Chipizdry/Inverters-in-development/100kW_380V_Inverter/DC-DC-Conv/Снимок экрана 2026-07-19 193247.png

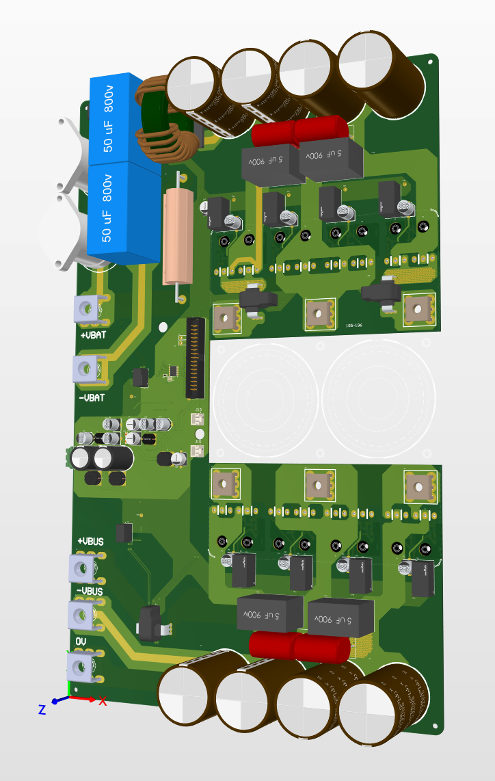
100kW_380V_Inverter/DC-DC-Conv/Снимок экрана 2026-07-19 193247.png
