Chipizdry/Inverters-in-development/100kW_380V_Inverter/Driver/ADC_Comm/ADC_Comm/Снимок экрана 2026-07-13 130827.png

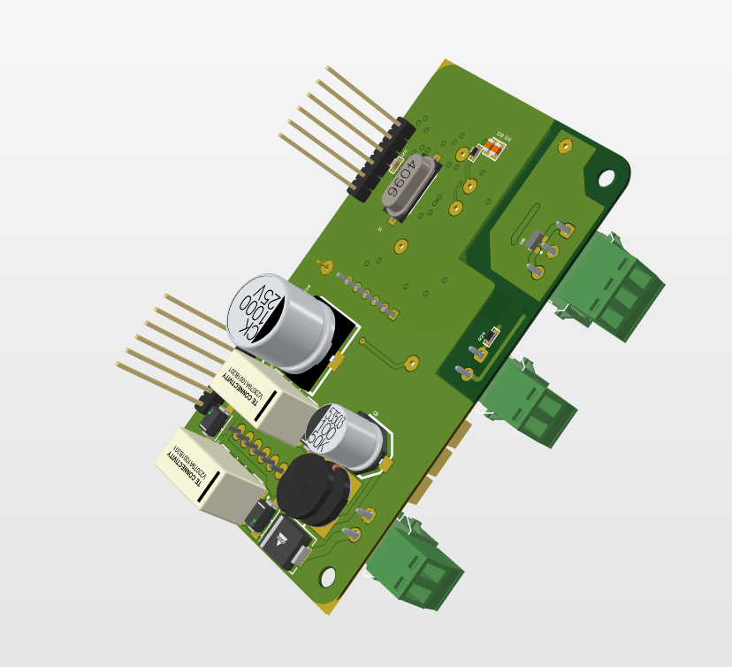
100kW_380V_Inverter/Driver/ADC_Comm/ADC_Comm/Снимок экрана 2026-07-13 130827.png
