Chipizdry/Inverters-in-development/100kW_380V_Inverter/Driver/PS_Filter/Project Outputs for PS_Filter/Снимок экрана 2026-05-31 180028.png

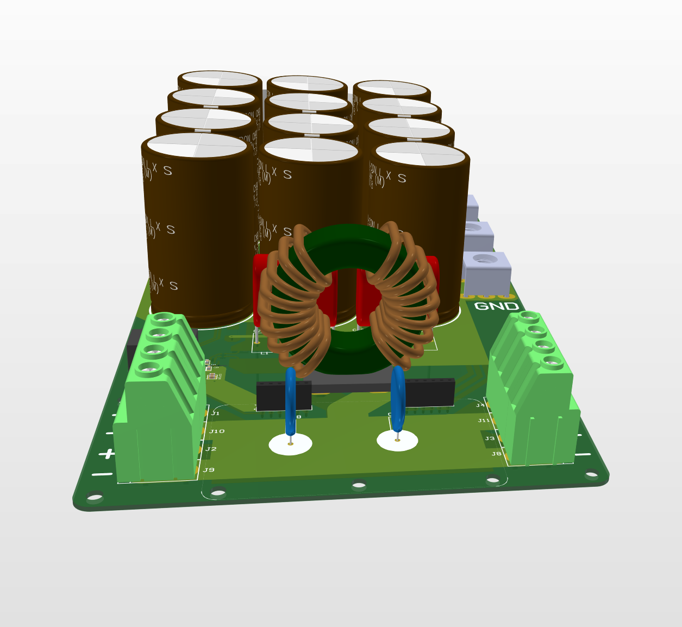
100kW_380V_Inverter/Driver/PS_Filter/Project Outputs for PS_Filter/Снимок экрана 2026-05-31 180028.png
