Chipizdry/Inverters-in-development/100kW_380V_Inverter/PS__INN3947CQ_V2/Project Outputs for Free Documents/BOM/BOM.xlsx

Designator | Quantity | Description | Footprint
C14 | 1 | 4.7uF | CAP-0805
C15 | 1 | 330pF 630V | CAP-1206
C16 | 1 | 1500pF 630V | CAP-1206
C17 | 1 | 2,2uF | CAP-1206
C18 | 1 | 470nF 100V | CAP-0805
C20 | 1 | 330pF | CAP-0805
C22 | 1 | 10nF | CAP-0805
C24 | 1 | 330pF 16V | CAP-0805
D2 | 1 | BAS21GWX | SOD-123
D4 | 1 | 1N4148 | SOD-123
D5 | 1 | PDZ15BGWJ | SOD-123
D6 | 1 | SS14 | DO-214AC, SMA
D7 | 1 | WURTH ELEKTRONIK - 151031YS06000 - LED, Yellow, Through Hole, T-1 (3mm), 30 mA, 2 V, 590 nm | LED_3mm_RED
IC1 | 1 | INN3947CQ | INN3947CQ
L1 | 1 | L_13x13mm | L_13x13mm
P1 | 1 | WR-TBL Series 7015B Open Horizontal PCB Header, SMT, pitch 5.08mm, 2p | 691701530002B
P2 | 1 | WR-TBL Series 7015B Open Horizontal PCB Header, SMT, pitch 5.08mm, 3p | 691701530003B
R12 | 1 | 8.2K | RES-0805
R16 | 1 | 100 OHM | RES-0805
R17 | 1 | 4,7 OHM | RES-0805
R20 | 1 | 9.1K | RES-0805
R22 | 1 | 100K | RES-0805
T1 | 1 | TRANS_PQ3220 | TRANS_PQ3220
C10, C11 | 2 | 6.8nF 630V | CAP-1206
C12, C13 | 2 | 10uF 50v | CAP-0805
D1, D3 | 2 | NRVUS2MA | SOD128, DO-214AC, SMA
Q1, Q2 | 2 | DMT15H017LPS | DMT15H017LPS_SWP
R1, R21 | 2 | 10K | RES-0805
R3, R6 | 2 | 7.5 OHM | RES-2512
R18, R19 | 2 | 12 OHM | RES-0805
R24, R25 | 2 | 0.027 OHM | RES-1206
C19, C21, C23 | 3 | 470uF 25V | CAPPOL_SMD_SIZE_E
C1, C2, C3, C4, C5, C6, C7, C8, C9 | 9 | 68nF 500V | CAP-1206
R4, R5, R7, R8, R9, R10, R11, R13, R14, R15 | 10 | 390K | RES-1206
