Chipizdry/Inverters-in-development/100kW_380V_Inverter/Driver/Driver_BLDC/Driver_PCB/Project Outputs for Driver_BLDC/Driver_BOM.xlsx

Comment | Description | Designator | Footprint | LibRef | Quantity | Model number | Manufacturer | Volume | 5 sets | Minimum quantity | Unit price | Total price
330pF | 330pF | C1, C2, C3, C87, C89, C90 | CAP-0805 | CAP-NON-POLAR | 6 | 0805B331K500NT | FH | 0805 | 30 | 100 | 0.004 | 0.443
100nF | 100nF | C4, C6, C64, C73, C97, C126 | CAP-0805 | CAP-NON-POLAR | 6 | 0805B104K500NT | FH | 0805 | 30 | 100 | 0.004 | 0.429
16V 100uF | 16V 100uF | C5 | CAP-TAN-D | CAP-POLAR | 1 | JVJ16V100M6x5 | JIERR | SMD,D6.3xL5.4mm | 5 | 10 | 0.043 | 0.429
47uF 16V | 47uF 16V | C7, C19, C21, C23, C30 | CAP-TAN-D | CAP-POLAR | 5 | JVJ16V47M5x5 | JIERR | SMD,D5xL5.4mm | 25 | 30 | 0.036 | 1.071
GRM21BR61C106KE15L | Chip Multilayer Ceramic Capacitors for General Purpose, 0805, 10uF, X5R, 15%, 10%, 16V | C8, C10 | FP-GRM21B-0_1-IPC_C | CMP-2007-03453-2 | 2 | GRM21BR61C106KE15L | muRata | 0805 | 10 | 20 | 0.021 | 0.429
0.1uF | 0.1uF | C9, C12, C13, C14, C15, C16, C17, C25, C29, C31, C35, C36, C38, C40, C42, C45, C46, C52, C53, C54, C59, C60, C62, C66, C69, C72, C75, C77, C82, C94, C112, C123, C143 | CAP-0805 | CAP-NON-POLAR | 33 | 0805B104K500NT | FH | 0805 | 165 | 200 | 0.004 | 0.857
2.2nF 2kV | 2.2nF 2kV | C11, C78, C81, C83, C84, C85 | CAP-V | CAP-V | 6 | R08E3E222MA5B0S0N0 | STE | CAP-V=7.5mm | 30 | 40 | 0.036 | 1.429
2.2uF | 2.2uF | C18, C48 | CAP-0805 | CAP-NON-POLAR | 2 | CL21A225KBQNNNE | SAMSUNG | 0805 | 10 | 50 | 0.017 | 0.857
1uF | 1uF | C20, C22, C24, C34, C56, C57, C70, C86, C102, C115, C138 | CAP-0805 | CAP-NON-POLAR | 11 | CL21B105KAFNNNE | SAMSUNG | 0805 | 55 | 100 | 0.011 | 1.143
47pF | 47pF | C26, C27 | CAP-0805 | CAP-NON-POLAR | 2 | 0805CG470J500NT | FH | 0805 | 10 | 100 | 0.006 | 0.571
1000pF | 1000pF | C28 | CAP-0805 | CAP-NON-POLAR | 1 | 0805B102K500NT | FH | 0805 | 5 | 50 | 0.004 | 0.214
100uF 16V | 100uF 16V | C32, C39, C61, C92, C110, C122, C142 | CAP-TAN-D | CAP_POL_SMD, CAP-POLAR | 7 | JVJ16V100M6x5 | JIERR | SMD,D6.3xL5.4mm | 35 | 50 | 0.039 | 1.929
1000uF 10V | 1000uF 10V | C33, C49, C63 | CAP_SMD_Size_G | CAP-POLAR | 3 | RVE10V1000M8X10 | JIERR | SMD,D8xL10.5mm | 15 | 30 | 0.071 | 2.143
1000uF_6.3V |  | C37, C43, C44, C50, C51, C67, C68 | CAP_SMD_Size_E | CAP-POLAR | 7 | JVJ6.3V1000M8X10 | JIERR | SMD,D8xL10.5mm | 35 | 50 | 0.071 | 3.571
220pF | 220pF | C41 | CAP-0805 | CAP-NON-POLAR | 1 | 0805B221K500NT | FH | 0805 | 5 | 50 | 0.006 | 0.286
25V_1000uF | 25V_1000uF | C47, C55 | HITANO 3300uF 25V 16x25 | CAP-POLAR | 2 | JVJ25V1000M10X12 | JIERR | SMD,D10xL12mm | 10 | 20 | 0.200 | 4.000
35V 220uF | 35V 220uF 8x10.5 | C58, C71, C88, C104, C117, C139 | CAP_SMD_Size_E | CAP-POLAR | 6 | RVT220UF35V67RV0024 | KNSCHA | SMD,D8xL10.2mm | 30 | 50 | 0.057 | 2.857
2.2nF | 2.2nF | C65, C98, C127 | CAP-0805 | CAP-NON-POLAR | 3 | 0805B222K500NT | FH | 0805 | 15 | 50 | 0.005 | 0.250
270pF | 270pF | C74 | CAP-0805 | CAP-NON-POLAR | 1 | 0805B271K500NT | FH | 0805 | 5 | 50 | 0.006 | 0.286
0.33uF | 0.33uF | C76 | CAP-0805 | CAP-NON-POLAR | 1 | CL21B334KBFNNNE | SAMSUNG | 0805 | 5 | 50 | 0.014 | 0.714
10nF 2kV | 10nF 2kV | C79, C80 | CAP-V | CAP-V | 2 | R11F1E103MN0B0S0N0 | STE | CAP-V=7.5mm | 10 | 20 | 0.071 | 1.429
151031YS06000 | WURTH ELEKTRONIK - 151031YS06000 - LED, Yellow, Through Hole, T-1 (3mm), 30 mA, 2 V, 590 nm | D1, D6, D7, D9 | LED_RED | LED | 4 | XL-1608SURC-06 | XINGLIGHT | 0603 | 20 | 100 | 0.004 | 0.429
151031YS06000 | WURTH ELEKTRONIK - 151031YS06000 - LED, Yellow, Through Hole, T-1 (3mm), 30 mA, 2 V, 590 nm | D2, D5 | LED_GREEN | LED | 2 | XL-1608UGC-04 | XINGLIGHT | 0603 | 10 | 100 | 0.004 | 0.429
151031YS06000 | WURTH ELEKTRONIK - 151031YS06000 - LED, Yellow, Through Hole, T-1 (3mm), 30 mA, 2 V, 590 nm | D3 | LED_YELLOW | LED | 1 | XL-1608UYC-06 | XINGLIGHT | 0603 | 5 | 100 | 0.007 | 0.714
151031YS06000 | WURTH ELEKTRONIK - 151031YS06000 - LED, Yellow, Through Hole, T-1 (3mm), 30 mA, 2 V, 590 nm | D4, D8 | LED_BLUE | LED | 2 | XL-1608UGC-04 | XINGLIGHT | 0603 | 10 | 100 | 0.004 | 0.429
SS36 | SS36 | D10 | SMC/DO214AB | SS36_Schottky | 1 | SS36 | YANGJIE | DO-214AB(SMC) | 5 | 10 | 0.143 | 1.429
1N4148 |  | D11, D13, D15 | DIOD-SOD123-2_V | 1N4148 | 3 | 1N4148W | R+O | SOD-123 | 15 | 50 | 0.006 | 0.286
US1G | US1G | D12, D14, D17, D19, D21, D24 | US1G_SMA | US1G | 6 | US1G | MDD | SMA | 30 | 50 | 0.014 | 0.714
ACS724 | ACS724 10A | DD1 | SO8-150 | ACS712 | 1 | ACS724LLCTR-05AB-T | Slkor | SOP-8 | 5 | 5 | 0.714 | 3.571
HEAT SINK | DNP | H1 | HEAT SINK | HEAT SINK | 1 |  |  |  | 5 |  | 0.000 | 0.000
MG_136_HT | MG_136_HT | J1, J2, J3, J4, J5, J7 | Conn_MEIGAN_MG136HT | Connector_MEIGAN_MG136HT | 6 | DB136H-10.16-3P-GN-P | DORABO | 1*3P=10.16mm | 30 | 30 | 0.857 | 25.714
DB9 pcb |  | J6 | DB9 conn pcb | DB9 | 1 | D-DMR009PM-D002 | Ckmtw | D-SUB/9P | 5 | 5 | 0.357 | 1.786
B6B-XH-TW |  | J10, J13 | B6B-XH-TW | B6B-XH-TW | 2 | WAFER-XH2.54-6PZZ | XUNPU | 1x6P/2.5mm | 10 | 20 | 0.023 | 0.457
G(4) | DNP | J14 | Klema_PCB_15A | Klema_15_A | 1 |  |  |  | 5 |  | 0.000 | 0.000
E(5) | DNP | J16 | Klema_PCB_15A | Klema_15_A | 1 |  |  |  | 5 |  | 0.000 | 0.000
G(6) | DNP | J19 | Klema_PCB_15A | Klema_15_A | 1 |  |  |  | 5 |  | 0.000 | 0.000
E(7) | DNP | J21 | Klema_PCB_15A | Klema_15_A | 1 |  |  |  | 5 |  | 0.000 | 0.000
G | DNP | J24, J29, J34, J38 | Klema_PCB_15A | Klema_15_A | 4 |  |  |  | 20 |  | 0.000 | 0.000
E | DNP | J26, J31, J36, J40 | Klema_PCB_15A | Klema_15_A | 4 |  |  |  | 20 |  | 0.000 | 0.000
 |  | J48, J49, J52, J53 | Sullins_SWR25X-NRTC-S06-ST-BA_MFG | SWR25X-NRTC-S06-ST-BA | 4 | WAFER-XH2.54-6PZZ | XUNPU | 1x6P/2.5mm | 20 | 30 | 0.023 | 0.686
100uH CD105 | 100uH CD105 | L1, L2 | WE-PD2_1054 | 744776122 | 2 | FCD105-220K | cjiang | SMD,10x9mm | 10 | 20 | 0.143 | 2.857
744776227 |  | L3 | WE-PD2_1054 | CMP-0227-00501-2 | 1 | SCD.1054.DYF271KT00 | SOREDE | SMD,10x9mm | 5 | 5 | 0.143 | 0.714
220uH CD75 | 220uH CD75 | L4, L6, L7 | WE-PD2_7850 | 74477530 | 3 | FCD75-102K | cjiang | SMD,7.8x7mm | 15 | 20 | 0.114 | 2.286
691305540002 | WR-TBL Series 3055 PCB Header Horizontal Entry with Plastic Latches, THT, pitch 5.08mm, 2p | P1, P8, P9, P10 | 691305540002 | 691305540002 | 4 | MX2EDGRC-5.08-02P-GN01-Cu-A | MAX | 1*2P=5.08mm | 20 | 30 | 0.043 | 1.286
61900311121 | WR-WTB THT Male Vertical Locking Header, pitch 2.54mm, 3p | P4, P5, P13, P14, P15 | 61900311121 | 61900311121 | 5 | HC-2510-3A | HCTL | 1x3P=2.54mm | 25 | 40 | 0.043 | 1.714
691305540003 | WR-TBL Series 3055 PCB Header Horizontal Entry with Plastic Latches, THT, pitch 5.08mm, 3p | P6, P7 | 691305540003 | 691305540003 | 2 | MX2EDGRC-5.08-03P-GN01-Cu-A | MAX | 1*3P=5.08mm | 10 | 20 | 0.057 | 1.143
BC847C | NPN Silicon AF Transistor, 45 V VCEO, 100 mA IC, SOT23, Reel, Green | Q1, Q2, Q3 | INF-SOT23_N | BC847C_Infineon | 3 | BC847C | Hottech | SOT-23 | 15 | 50 | 0.014 | 0.714
BSS84 | P-mosfet | Q4 | FP-SOT23-IPC_A | BSS84 | 1 | BSS84 | CJ | SOT-23 | 5 | 50 | 0.019 | 0.929
10K | 10K | R1, R2, R3, R4, R5, R6, R13, R14, R15, R16, R17, R18, R19, R20, R21, R24, R25, R26, R27, R28, R31, R33, R34, R35, R37, R38, R40, R41, R42, R43, R44, R45, R48, R49, R51, R53, R56, R57, R58, R59, R61, R69, R73, R81, R88, R95, R108, R113, R118, R120, R121, R122, R123, R124, R125, R128, R135, R143, R147, R152 | RES-0805 | RES-CONST | 60 | RC0805FR-0710KL | YAGEO | 0805 | 300 | 400 | 0.002 | 0.914
220 | 220 | R7, R8, R9, R10, R11, R12, R39, R46, R47 | RES-0805 | RES-CONST | 9 | RC0805FR-07220RL | YAGEO | 0805 | 45 | 100 | 0.003 | 0.286
20K | 20K | R22, R23 | RES-0805 | RES-CONST | 2 | RC0805FR-0720KL | YAGEO | 0805 | 10 | 100 | 0.003 | 0.286
30K | 30K | R29, R30 | RES-0805 | RES-CONST | 2 | 0805W8J0303T5E | YAGEO | 0805 | 10 | 100 | 0.003 | 0.286
100 | 100 | R32, R36 | RES-0805 | RES-CONST | 2 | RT0805BRD07100RL | YAGEO | 0805 | 10 | 100 | 0.003 | 0.286
1K | 1K | R50, R54, R55, R63, R64, R78, R84, R86, R87, R91, R93, R98, R99, R102, R103, R109, R110, R111, R116, R117, R126, R127, R140 | RES-0805 | RES-CONST | 23 | RC0805JR-071KL | YAGEO | 0805 | 115 | 200 | 0.003 | 0.571
47K | 47K | R52 | RES-0805 | RES-CONST | 1 | RC0805JR-0747KL | YAGEO | 0805 | 5 | 100 | 0.003 | 0.286
10 | 10 | R60, R77, R92, R115, R131, R149 | RES-2512 | RES-CONST | 6 | 25121WF100JT4E | UNI-ROYAL | 2512 | 30 | 40 | 0.037 | 1.486
1K | 1K | R62, R82, R96, R119, R136, R153 | RES-2512 | RES-CONST | 6 | 25121WJ0102T4E | UNI-ROYAL | 2512 | 30 | 40 | 0.029 | 1.143
36K | 36K | R65 | RES-0805 | RES-CONST | 1 | 0805W8F3602T5E | UNI-ROYAL | 0805 | 5 | 100 | 0.003 | 0.286
100K | 100K | R66, R72, R107, R146 | RES-0805 | RES-CONST | 4 | 0805W8F1003T5E | UNI-ROYAL | 0805 | 20 | 100 | 0.003 | 0.286
11K | 11K | R67 | RES-0805 | RES-CONST | 1 | RC0805FR-0711KL | YAGEO | 0805 | 5 | 100 | 0.003 | 0.286
2K | 2K | R68 | RES-0805 | RES-CONST | 1 | RC0805FR-072KL | YAGEO | 0805 | 5 | 100 | 0.003 | 0.286
100K | 100K 1%, 100K 1% | R70, R71, R74 | RES-2512 | RES-CONST | 3 | RC0805FR-07100KL | YAGEO | 0805 | 15 | 100 | 0.003 | 0.286
1K 1% | 1K 1% (DNP) | R75 | RES-0805 | RES-CONST | 1 | RC0805JR-071KL | YAGEO | 0805 | 5 | 200 | 0.003 | 0.571
3K | 3K | R76, R104, R132 | RES-0805 | RES-CONST | 3 | RC0805FR-073KL | YAGEO | 0805 | 15 | 100 | 0.003 | 0.286
1M | 1M | R79 | RES-0805 | RES-CONST | 1 | RC0805JR-071ML | YAGEO | 0805 | 5 | 100 | 0.003 | 0.286
1K 1% | 1K 1% | R80 | RES_SMD_1210_IPC_B | RES_1210 | 1 | 1210W2F1001T5E | UNI-ROYAL | 1210 | 5 | 50 | 0.011 | 0.571
4.99R | 5 | R83, R85, R89, R90, R94, R97, R100, R101, R105, R106, R112, R114 | RES-0805 | RES-CONST | 12 | RC0805FR-074R99L | YAGEO | 0805 | 60 | 100 | 0.007 | 0.714
BC847C |  | T1 | SOT23-3_IPC_A | BC847C | 1 | BC847C | R+O | SOT-23 | 5 | 50 | 0.010 | 0.500
 | Test_Point | TP1, TP2, TP3, TP6, TP7, TP8, TP16, TP24, TP28, TP29, TP61 | Test_Point | TP_PCB? | 11 |  |  |  | 55 |  | 0.000 | 0.000
Test_Point_PCB | Test_Point | TP4, TP5, TP9, TP10, TP11, TP12, TP13, TP14, TP15, TP17, TP18, TP19, TP20, TP21, TP22, TP23, TP25, TP26, TP27, TP31, TP34, TP36, TP40, TP41, TP42, TP43, TP44, TP46, TP47, TP48, TP49, TP50, TP52, TP53, TP54, TP56, TP57, TP58, TP59, TP62, TP64, TP65, TP66, TP67, TP69 | Test_Point | TP_PCB? | 45 |  |  |  | 225 |  | 0.000 | 0.000
Test_Point_PCB | Test_Point | TP30 | Pin_Test_Point(Pink) | TP_PCB? | 1 |  |  |  | 5 |  | 0.000 | 0.000
DC-DC | Mounted by the customer | U1, U6, U10 | DC-DC_Bridge | DC-DC/12-18VDC | 3 |  |  |  | 15 |  | 0.000 | 0.000
B0505S-1W | B0505S-1W | U2, U12 | B0505S-1W | B0505S-1W | 2 | B0505S-1WR3 | EVISUN | SIP,11.7x6mm | 10 | 10 | 0.643 | 6.429
MAX485 |  | U3 | SOIC-8-MFG | MAX485 | 1 | MAX485ESA(UMW) | UMW | SOP-8 | 5 | 10 | 0.143 | 1.429
ADUM1401BRWZ | Quad Channel Digital Isolator, 2.5 KV rms Insulation Rating, 10 Mbps Data Rate, 50 ns Delay, Industrial, 16-pin SOIC (RW-16), Tube | U4 | ADI-RW-16_M | CMP-0534-00565-1 | 1 | ADUM1401BRWZ-RL | ADI | SOIC-16-300mil | 5 | 5 | 2.857 | 14.286
AD8605ARZ | AD8605ARZ | U5 | SOT-23-5 | MCP6001T | 1 | MCP6001T-I/OT | MICROCHIP | SOT-23-5 | 5 | 5 | 0.257 | 1.286
AMC1311 |  | U7 | FP-DWV0008A-MFG | AMC1311 | 1 | AMC1311DWVR | TI | SOP-8-300mil | 5 | 5 | 1.114 | 5.571
STM32F722RET6 |  | U8 | LQFP64-5W-IPC_A | STM32F722RET6 | 1 | STM32F722RET6 | ST | LQFP-64(10x10) | 5 | 5 | 5.429 | 27.143
AMS1117-3v3 | AMS1117-3v3 | U9, U11 | SOT-223-3 | AMS1117 | 2 | AMS1117-3.3V | MSKSEMI | SOT-223 | 10 | 20 | 0.057 | 1.143
UCC21520DW | UCC21520DW | U13, U21, U32 | FP-DW0016B-MFG | UCC21520DW | 3 | UCC21520DWR | TI | SOIC-16-300mil | 15 | 15 | 0.786 | 11.786
AD8605ARZ | AD8605ARZ | U14 | SOT-23-5 | MCP6001T | 1 | MCP6001T-I/OT | MICROCHIP | SOT-23-5 | 5 | 5 | 0.257 | 1.286
W25Q128 | W25Q128 | U15 | WINB-SOIC-8_M | W25Q128 | 1 | W25Q128 | Winbond | SOIC-8-208mil | 5 | 5 | 1.571 | 7.857
SN74HC541DWR | SN74HC541DWR | U16 | DW0020A_L | SN74HC541DWR | 1 | SN74HC541DWR | TI | SOIC-20-300mil | 5 | 5 | 0.786 | 3.929
AMS1117-5V1 | AMS1117-5V1 | U17, U19 | SOT-223 | AMS1117 | 2 | MS1117-5V | MSKSEMI | SOT-223 | 10 | 20 | 0.057 | 1.143
LM2576HVS-ADJ | LM2576HVS-ADJ | U18 | ON_Semiconductor_936A-02_MFG | LM2576D2T-005G | 1 | LM2576D2T-005G | onsemi | D2PAK-5 | 5 | 5 | 2.143 | 10.714
PC817XN |  | U20 | FP-PC817XNNIP0F-MFG | PC817XN | 1 | PC817XNNIP0F | SHARP | SOP4 | 5 | 5 | 0.286 | 1.429
SMBJ18CA |  | VD2, VD6, VD11, VD15, VD21, VD25 | DO-214AA | Suppressor | 6 | SMBJ18CA | R+O | DO-214AA(SMB) | 30 | 50 | 0.039 | 1.929
5.1V | 1N4733A 5.1V | VD4, VD8, VD13, VD17, VD23, VD27 | DO-35 | ZENER | 6 | 1N4733A | LGE | DO-41 | 30 | 50 | 0.064 | 3.214
IGBT 75N120T | IGBT 75N120T TO-247-3 DNP, IGBT 75N120T TO-264-3 | VT1, VT2, VT3, VT4, VT5, VT6, VT7, VT8, VT9, VT10, VT11, VT12 | TO-264-3 | IGBT 60N120T | 12 | IKQ75N120CS6 | Infineon | TO-247-3 | 60 | 60 | 2.286 | 137.143
FOXSLF/120-20(16MHZ) | Resistance Weld Thru-Hole Crystal, 16 MHz, +/-30 ppm, -20 to 70 degC, 2-Pin THD, RoHS, Bulk | Y1 | FOX-FOXSLF-2_V | CMP-1749-00004-1 | 1 | TAXD12M2GLFBET2T | YJX | HC-49S | 5 | 10 | 0.071 | 0.714
P6SMB16CA |  | ZD1, ZD2 | DO-214AA | P6SMB16CA | 2 | P6SMB16CA | R+O | DO-214AA(SMB) | 10 | 10 | 0.043 | 0.429
PCB | FR-4 board, double-sided, 2mm thickness, green solder mask with white text, 1oz copper thickness, covered vias, lead-free spray tin |  |  |  | 1 |  |  |  | 5 | 5 |  | 52
SMT Stencil |  |  |  |  | 1 |  |  |  | 1 | 1 |  | 20
SMT Soldering Cost |  |  |  |  | 1 |  |  |  | 5 | 5 |  | 200
Freight cost |  |  |  |  |  |  |  |  |  |  |  | 44
 |  |  |  |  |  |  |  |  |  |  |  | 638$
