Chipizdry/Inverters-in-development/100kW_380V_Inverter/Driver/Driver_BLDC/Driver_PCB/Optic_sensor_quad/Project Outputs for Optic_sensor_quad/Optic_sensor_quad.xlsx

Comment | Description | Designator | Footprint | LibRef | Quantity
25 uF 16V | 25 uF 16V | C1 | CAP-TAN-C | CAP-POLAR | 1
0.1uF | 0.1uF | C2, C3, C5, C6, C7 | CAP-0603 | CAP-NON-POLAR | 5
1uF | 1uF | C4 | CAP-0603 | CAP-NON-POLAR | 1
151031YS06000 | WURTH ELEKTRONIK - 151031YS06000 - LED, Yellow, Through Hole, T-1 (3mm), 30 mA, 2 V, 590 nm | D1, D2, D3, D4 | LED_GREEN | LED | 4
QRE1113 |  | DD1, DD2, DD3, DD4 | QRE1113 | QRE1113 | 4
653006114822 | WR-WTB THT Male Vertical Shrouded Header, pitch 1.25mm, 6p | P1 | 653006114822 | 653006114822 | 1
680 | 680 | R1, R9, R10, R11 | RES-0603 | RES-CONST | 4
100 | 100 | R2 | RES-0603 | RES-CONST | 1
100K | 100K | R3, R6, R7, R8 | RES-0603 | RES-CONST | 4
1K | 1K | R4, R5 | RES-0603 | RES-CONST | 2
MCP6004 | MCP6004 TSSOP | U1 | TSSOP-ST14_L | MCP6004 | 1
SMF5.0A | SMF5.0A SOD-123 | V1 | SOD-123 | SMF5.0A | 1
