Chipizdry/Inverters-in-development/100kW_380V_Inverter/DC-DC_Isolation/DC-DC_Isolation_prise.xlsx

Comment | Description | Designator | Footprint | LibRef | Quantity |  | Model number | Manufacture |  | 12 sets | Minimum quantity
50V_100uF | 50V_100uF | C1, C2, C4, C5 | CAP_SMD_Size_G | CAP-POLAR | 4 | C46550415 | JVJ50V100M6x8 | JIERR | SMD,D6.3xL7.7mm | 48 | 50 | 0.062 | 3.1
330uF_25V | 330uF_25V, [NoValue] | C3, C6, C19 | CAP_SMD_Size_G | CAP-POLAR | 3 | C46550406 | JVJ25V330M6x8 | JIERR | SMD,D6.3xL7.7mm | 36 | 40 | 0.110 | 4.4
0.1uF | 0.1uF X7R, 0.1uF | C7, C8, C9, C10, C11, C12 | CAP-0805 | CAP-NON-POLAR | 6 | C1711 | CL21B104KBCNNNC | SAMSUNG | 0805 | 72 | 80 | 0.024 | 1.92
63V 0.01UF | WIMA Film Capacitor FKP2 63V 0.01UF | C13, C14 | FKP2D011001A00JSSD | CAP-NON-POLAR | 2 | C5121924 | C241J103J20C000 | faratronic | P=5mm | 24 | 30 | 0.066 | 1.98
100uF_16V | 100uF_16V | C15 | CAP-TAN-D | CAP-POLAR | 1 | C7223 | TAJD107K016RNJ | Kyocera AVX | CASE-D-7343-31(mm) | 12 | 12 | 0.700 | 8.4
100nF | 100nF | C16, C20, C21, C24，C18, C29 | CAP-0603 | CAP-NON-POLAR | 6 | C1591 | CL10B104KB8NNNC | SAMSUNG | 0603 | 72 | 100 | 0.015 | 1.5
0.01uF | 0.01uF | C17 | CAP-0805 | CAP-NON-POLAR | 1 | C18741 | CL21B103KCANNNC | SAMSUNG | 0805 | 12 | 50 | 0.020 | 1
0.01uF | DNP | C22, C30 | CAP-0603 | CAP-NON-POLAR | 2 |  |  |  |  | 24 |  |  | 0
470uF_25V | 470uF_25V | C23 | CAP_SMD_Size_G | CAP-POLAR | 1 | C46550407 | JVJ25V470M8x10 | JIERR | SMD,D8xL10.5mm | 12 | 15 | 0.110 | 1.65
2.2nF | 2.2nF | C25 | CAP-0603 | CAP-NON-POLAR | 1 | C16033 | CL10B222KB8NNNC | SAMSUNG | 0603 | 12 | 50 | 0.012 | 0.6
100nF | 100nF | C26 | CAP-0805 | CAP-NON-POLAR | 1 | C1711 | CL21B104KBCNNNC | SAMSUNG | 0805 | 12 | 50 | 0.022 | 1.1
0.47uF | 0.47uF | C27 | CAP-0603 | CAP-NON-POLAR | 1 | C1623 | CL10B474KA8NNNC | SAMSUNG | 0603 | 12 | 20 | 0.030 | 0.6
470 pF | 470 pF | C28 | CAP-0603 | CAP-NON-POLAR | 1 | C22396 | CL10B471KB8NNNC | SAMSUNG | 0603 | 12 | 100 | 0.007 | 0.7
ES1D-M3 | ES1D-M3 | D1, D2, D3, D4, D5, D6, D9, D10 | FP-SMA-MFG | ES1D-M3 | 8 | C2979777 | ES1D-M3/61T | VISHAY | SMA(DO-214AC) | 96 | 100 | 0.360 | 36
LED_GREEN | LED_GREEN | D7, D8 | LED_GREEN | LED | 2 | C965815 | XL-2012UGC | XINGLIGHT | 0805 | 24 | 100 | 0.007 | 0.7
SMBJ33CA-13-F | TVS DIODE 33V 53.3V SMB | D11, D12 | FP-SMB-CA-MFG | SMBJ33CA-13-F | 2 | C135068 | SMBJ33CA-13-F | DIODES | SMB | 24 | 25 | 0.235 | 5.875
LED_RED | LED_RED | D13 | LED_RED | LED | 1 | C965812 | XL-2012SURC | XINGLIGHT | 0805 | 12 | 100 | 0.007 | 0.7
LM7818 |  | DD1, DD2 | TO-252 | LM7818 | 2 | C115123 | MC78M18CDTRKG | onsemi | TO-252 | 24 | 24 | 0.300 | 7.2
BLM21PG221SN1D | Chip Ferrite Bead, 0805, 220Ω @ 100MHz, 0.045Ω, 25%, 2A | FB1, FB2 | FP-BLM21-0_2-t0_85-e0_5-IPC_B | CMP-0686-00610-3 | 2 | C85840 | BLM21PG221SN1D | muRata | 0805 | 24 | 30 | 0.026 | 0.78
SRN6045TA-220M | FIXED IND 22UH 2.3A 96 MOHM SMD | L1, L2 | FP-SRN6045TA-MFG | CMP-07248-000061-1 | 2 | C2044314 | SRN6045TA-220M | BOURNS | SMD,6x6mm | 24 | 25 | 0.330 | 8.25
330µH, 0.38A | WE-PD2 SMT Power Inductor, size 7850, 390µH, 0.38A, 1.77Ω | L3 | WE-PD2_7850 | 744775239 | 1 | C436716 | PSPNAQ5040-331M | PROD | SMD,5x5mm | 12 | 15 | 0.065 | 0.975
61301811021 | WR-PHD Pin Header, THT, Angled, pitch 2.54mm, 1 Row, 18P | P1 | 61301811021 | 61301811021 | 1 | C2883856 | X6511WR-18H-C60D30R1 | XKB Connection | 1x18P,P=2.54mm | 12 | 12 | 0.350 | 4.2
10K | 10K | R1, R2 | RES-0805 | RES-CONST | 2 | C84376 | RC0805FR-0710KL | YAGEO | 0805 | 24 | 100 | 0.012 | 1.2
10 OMH | 10 OMH | R3, R4 | RES-1206 | RES-CONST | 2 | C108080 | RC1206FR-0710RL | YAGEO | 1206 | 24 | 30 | 0.035 | 1.05
10K | 10K | R5, R14, R17 | RES-0603 | RES-CONST | 3 | C98220 | RC0603FR-0710KL | YAGEO | 0603 | 36 | 100 | 0.010 | 1
2K | 2K | R6, R7, R18 | RES-0603 | RES-CONST | 3 | C105576 | RC0603FR-072KL | YAGEO | 0603 | 36 | 100 | 0.004 | 0.4
820 | 820 | R8 | RES-0603 | RES-CONST | 1 | C23253 | 0603WAF8200T5E | UNI-ROYAL | 0603 | 12 | 100 | 0.003 | 0.3
200K | 200K | R9, R10 | RES-0603 | RES-CONST | 2 | C105574 | RC0603FR-07200KL | YAGEO | 0603 | 24 | 100 | 0.006 | 0.6
1K | 1K | R11, R19, R20, R22, R23, R24, R27 | RES-0603 | RES-CONST | 7 | C22548 | RC0603FR-071KL | YAGEO | 0603 | 84 | 100 | 0.006 | 0.6
10 | 10 | R12, R13 | RES-0805 | RES-CONST | 2 | C96347 | RC0805FR-0710RL | YAGEO | 0805 | 24 | 50 | 0.018 | 0.9
6.2K | 6.2K | R15 | RES-0603 | RES-CONST | 1 | C17767 | 0805W8F6201T5E | UNI-ROYAL | 0805 | 12 | 100 | 0.006 | 0.6
10 | 10 | R16, R21 | RES-0603 | RES-CONST | 2 | C109318 | RC0603FR-0710RL | YAGEO | 0603 | 24 | 100 | 0.010 | 1
1 | 1 | R25, R26 | RES-2512 | RES-CONST | 2 | C11254 | 25121WF100KT4E | UNI-ROYAL | 2512 | 24 | 30 | 0.110 | 3.3
RM-6 | Core type: RM6 Ferrite material: PC40 / N87 / equivalent Gap: 0 mm (Ungapped core) Bobbin: RM6 standard | T1 | TRANS_RM6 | RM_6_12-12-18-18 | 1
BC847C |  | T2 | SOT23-3_IPC_A | BC847C | 1 | C7420337 | BC847C | R+O | SOT-23 | 12 | 50 | 0.015 | 0.75
IRFL024ZTRPBF | IRFL024ZTRPBF | T3, T4 | SOT-223-3 | IRFL024ZTRPBF | 2 | C80625 | IRFL024ZTRPBF | Infineon | SOT-223 | 24 | 24 | 0.420 | 10.08
Test_Point_PCB | Test_Point | TP1, TP2, TP3 | Test_Point | TP_PCB? | 3 |  |  |  |  | 36 |  |  | 0
 | Test_Point | TP4, TP5, TP6, TP7, TP10, TP12, TP13 | Test_Point | TP_PCB? | 7 |  |  |  |  | 84 |  |  | 0
TL494CDR | Pulse-Width-Modulation Control Circuit with Voltage Control, 45 % Duty Cycle, 0 to +70 degC, 16-pin SOIC (D), Green (RoHS & no Sb/Br) | U1 | D0016A_N | CMP-0319-00950-2 | 1 | C19882 | TL494CDR | TI | SOIC-16-150mil | 12 | 12 | 0.280 | 3.36
UCC27524DSDR | IC GATE DVR LO-SIDE DL 5A 8SON | U2 | FP-DSD0008D-IPC_A | UCC27524DSDR | 1 | C2676911 | UCC27524DSDR | TI | SON-8-EP(3x3) | 12 | 12 | 0.550 | 6.6
TL431 | TL431_SOT-23-3 | U3, U4 | TL431_SOT-23-3(A) | TL431_SOT-23-3 | 2 | C316457 | TL431QDBZR | TI | SOT-23-3 | 24 | 25 | 0.110 | 2.75
PCB | FR-4 material, double-sided, board thickness 1.6mm, green solder mask with white silkscreen, 1oz copper thickness, via-in-pad (tented), lead-free HASL |  |  |  |  |  |  |  |  |  |  |  | 22
SMT Stencil |  |  |  |  |  |  |  |  |  |  |  |  | 20
SMT Soldering Cost |  |  |  |  |  |  |  |  |  |  |  |  | 80
Freight cost |  |  |  |  |  |  |  |  |  |  |  |  | 15
 |  |  |  |  |  |  |  |  |  |  |  |  | 263.12
