Chipizdry/Inverters-in-development/100kW_380V_Inverter/DC-DC-Conv/DC-DC_Conv.xlsx

Comment | Description | Designator | Footprint | LibRef | Quantity
550V_470uF | 550V_470uF | C1, C3, C5, C6, C7, C8, C10, C11 | 500V_470uF | CAP_POL_LOW_IMP | 8
0.1uF | 0.1uF X7R, 0.1uF | C2, C14, C20, C25, C26, C31, C42, C51, C60, C65, C66, C71, C72, C79, C80, C82, C83, C86, C88, C91, C98, C101, C102, C105, C107, C108 | CAP-0805 | CAP-NON-POLAR | 26
0.01uF | 0.01uF X7R | C4, C21, C27, C43, C61, C67, C73, C84 | CAP-0805 | CAP-NON-POLAR | 8
100uF_50V | 100uF_50V | C9, C22, C28, C46, C62, C68, C75, C85 | CAP_SMD_Size_E | CAP_POL_SMD | 8
2.2uF | 2.2uF | C12, C23, C29, C47, C63, C69, C76, C87 | CAP-0805 | CAP-NON-POLAR | 8
16V_47uF | 16V_47uF | C13, C24, C30, C49, C64, C70, C78, C90 | CAP-TAN-C | CAP_POL_SMD | 8
4.7uF_630V | 4.7uF_630V CBB21, 4.7uF_630V | C15, C16, C18, C19 | CAP_4.7uF_630V | CAP-NON-POLAR | 4
50uF 800V | Z121578672 77G EPCOS 77G 50UF 800V | C17, C92 | Z121578672 77G | CAP-NON-POLAR | 2
100nF | 100nF | C32, C35 | CAP-0603 | CAP-NON-POLAR | 2
0.01uF | 0.01uF | C33, C36, C40, C41, C93, C96, C111, C118, C120 | CAP-0603 | CAP-NON-POLAR | 9
1uF | 1uF | C34, C37 | CAP-0603 | CAP-NON-POLAR | 2
2.2uF | 2.2uF | C38, C39, C44, C45, C94, C95, C112, C119, C121 | CAP-0603 | CAP-NON-POLAR | 9
1nF | 1nF | C48, C50 | CAP-0805 | CAP-NON-POLAR | 2
10nF | 10nF | C52, C53 | CAP-0805 | CAP-NON-POLAR | 2
4.7nF | 4.7nF | C54, C55 | CAP-0603 | CAP-NON-POLAR | 2
470pF | 470pF | C56, C57, C58, C59 | CAP-0805 | CAP-NON-POLAR | 4
25V_1000uF | 25V_1000uF | C74, C81 | HITANO 3300uF 25V 16x25 | CAP-POLAR | 2
1uF | 1uF | C77, C110 | CAP-0805 | CAP-NON-POLAR | 2
1000uF 6.3V | 1000uF 6.3V | C89, C99, C100, C104, C106 | CAP_SMD_Size_E | CAP-POLAR | 5
1000uF 10V | 1000uF 10V | C97, C103 | CAP_SMD_Size_G | CAP-POLAR | 2
330uF 25V | 330uF 25V | C109, C117 | CAP_SMD_Size_G | CAP-POLAR | 2
5.0uf 900V | C4AE 5.0uf 900V | C113, C114, C115, C116 | AV C4AE 5.0uf 900V | CAP-NON-POLAR | 4
US1G | US1G | D1, D3, D5, D7, D9, D11, D13, D16, D18, D20, D22, D24, D26, D28, D30, D32 | US1G_SMA | US1G | 16
SMBJ15CA-TR | SMBJ15CA-TR | D2, D4, D6, D8, D10, D12, D14, D17, D19, D21, D23, D25, D27, D29, D31, D33 | FP-SMB-CA-MFG | SMBJ15CA-TR | 16
SS36 | SS36 | D15 | SMC/DO214AB | SS36_Schottky | 1
LED_GREEN 0805 | LED_GREEN 0805 | D34 | LED_GREEN | LED | 1
18 * 18MM 180A PCB | 18 * 18MM 180A PCB High Current Solder Terminal Copper Terminal Fastener M8 Nut | J1, J2, J3, J4, J5 | M8 Conn | Klema_15_A | 5
M5 PCB | M5 PCB | J6, J7, J8, J9, J11, J12 | M5_Conn | Klema_15_A | 6
B2B-XH-A | B2B-XH-A | J10, J13 | B2B-XH-A | B2B-XH-A | 2
SEV30ADXL | 5-1000V 30A DC Contactor Power Relay SEV30ADXL Coil 12V | K1, K2 | Relay_1000VDC_30A | Relay | 2
Coil_relay |  | K3, K4 | Relay_Coil | Coil_relay | 2
100uH CD105 | 100uH CD105 | L1, L4, L5 | WE-PD2_1054 | CMP-0227-00501-2, 744776122 | 3
t472715-2mh 50A | t472715-2mh 50A | L2 | T47x27x15 | Drossel_Synphaze | 1
220uH CD75 | 220uH CD75 | L7, L8 | WE-PD2_7850 | 74477530 | 2
691305540002 | WR-TBL Series 3055 PCB Header Horizontal Entry with Plastic Latches, THT, pitch 5.08mm, 2p | P1 | 691305540002 | 691305540002 | 1
61203421621 | WR-BHD Male Box Header, THT Straight, pitch 2.54 mm, 2 Rows, 34 Pins | P2 | 61203421621 | 61203421621 | 1
10 | 10 | R1, R3, R6, R7, R9, R11, R13, R34, R36, R64, R66, R67, R69, R71, R73, R74, R78, R80, R82, R83, R85, R86, R88, R90, R92, R93, R95, R97, R99, R100, R102, R104 | RES-1206 | RES-CONST | 32
150 | 150 | R2, R10, R39, R70, R79, R89, R96, R103 | RES-0603 | RES-CONST | 8
1K | 1K | R4, R8, R12, R35, R65, R68, R72, R75, R81, R84, R87, R91, R94, R98, R101, R105 | RES-0805 | RES-CONST | 16
100 | 100W RX24 Aluminum Power Metal Shell Case Wirewound Resistor 100Omh | R5 | RES_100W_Aluminium | RES-CONST | 1
10K | 10K | R14, R15, R16, R17, R18, R19, R20, R21, R22, R23, R24, R25, R26, R27, R28, R29, R30, R31, R42, R43, R50, R51 | RES-0603 | RES-CONST | 22
200K | 200K | R32, R33, R37, R38, R40, R41, R56, R57, R60, R61, R62, R63 | RES-1206 | RES-CONST | 12
100 | 100 | R44, R45, R46, R47, R54, R55 | RES-0603 | RES-CONST | 6
2.4K | 2.4K | R48, R49 | RES-1206 | RES-CONST | 2
10K | 10K | R52, R53, R58, R59 | RES-0805 | RES-CONST | 4
11K | 11K | R76 | RES-0805 | RES-CONST | 1
2K | 2K | R77 | RES-0805 | RES-CONST | 1
220 | 220 | R106 | RES-0603 | RES-CONST | 1
C3M0022120D | C3M0022120D | T1, T2, T3, T4, T5, T6, T7, T8, T9, T10, T11, T12, T13, T14, T15, T16 | TO-247-3(BEND2) | C3M0022120D | 16
Test_Point_PCB | Test_Point | TP2, TP3, TP4, TP5, TP6, TP7, TP8, TP9, TP10, TP11, TP12, TP13, TP14, TP15, TP16, TP17, TP18, TP19, TP20 | Test_Point | TP_PCB? | 19
 | Test_Point | TP21 | Test_Point | TP_PCB? | 1
TLP5754 | TLP5754 | U1, U5, U7, U10, U18, U20, U22, U25 | SO6L_TOS | TLP5754 | 8
MGJ2D121505SC | MGJ2D121505SC | U2, U6, U9, U13, U19, U21, U23, U27 | FP-MGJ2D121505SC-MFG | MGJ2D121505SC | 8
STK-PL50A | STK-PL50A | U3, U4, U28, U31 | STK-PL50A | STK-PL50A | 4
SN74LVC541APWR | SN74LVC541APWR | U8 | PW0020A_L | SN74LVC541APWR | 1
B0505S-1W | B0505S-1W | U11, U12 | B0505S-1W | B0505S-1W | 2
OPA320AIDBVT | OPA320AIDBVT | U14, U16 | DBV0005A_M | OPA320AIDBVT | 2
AMC1311B | AMC1311B | U15, U17 | FP-DWV0008A-MFG | AMC1311 | 2
LM2576HVS-ADJ | LM2576HVS-ADJ | U24 | ON_Semiconductor_936A-02_MFG | LM2576D2T-005G | 1
AMS1117-3v3 | AMS1117-3v3 | U26 | SOT-223-3 | AMS1117 | 1
AMS1117-5V1 | AMS1117-5V1 | U29, U30 | SOT-223 | AMS1117 | 2
