Chipizdry/Inverters-in-development/100kW_380V_Inverter/GATE_BOARD/GATE_BOARD.xlsx

Comment | Description | Designator | Footprint | LibRef | Quantity
330pF | 330pF | C1, C2 | CAP-0805 | CAP-NON-POLAR | 2
LED_GREEN 0805 | LED_GREEN 0805 | D1, D2 | LED_GREEN | LED | 2
SMBJ18CA | TVS DIODE 18V 29.2V DO214AA | D3, D4 | FP-SMBJ-MFG | CMP-08607-000021-1 | 2
Test_Point_PCB | Test_Point | EH, EL, GL | Conn_Pad | TP_PCB? | 3
10K | 10K | R1, R2 | RES-1206 | RES-CONST | 2
5.1 | 5.1 | R3, R4 | RES-2512 | RES-CONST | 2
1K | 1K | R5, R6 | RES-0805 | RES-CONST | 2
GH | Test_Point | TP4 | Conn_Pad | TP_PCB? | 1
XH2.54 2p | XH2.54 2p | X1, X2 | CONN-PLS-2-2.54mm | CONN-2-PIN | 2
