Chipizdry/Inverters-in-development/100kW_380V_Inverter/Driver/ADC_Comm/ADC_Comm/ADC_Comm_.xlsx

Comment | Description | Designator | Footprint | LibRef | Quantity
100uF_16V | 100uF_16V | C1, C2, C5, C6, C11, C24, C27 | CAP-TAN-D | CAP_POL_SMD, CAP-POLAR | 7
16pF | 16pF | C3, C14 | CAP-0402 | CAP-NON-POLAR | 2
470pF | 470pF | C4 | CAP-0603 | CAP-NON-POLAR | 1
0.1uF | 0.1uF | C7, C10, C12, C13, C20, C21, C22, C23, C25, C26, C32 | CAP-0603 | CAP-NON-POLAR | 11
330uF 25V | 330uF 25V | C8 | CAP_SMD_Size_E | CAP_POL_SMD | 1
0.47uF | 0.47uF | C9 | CAP-0805 | CAP-NON-POLAR | 1
2.2uF | 2.2uF | C15, C19 | CAP-0805 | CAP-NON-POLAR | 2
0.01uF | 0.01uF | C16 | CAP-0805 | CAP-NON-POLAR | 1
100nF | 100nF | C17 | CAP-0603 | CAP-NON-POLAR | 1
1000uF_25V | 1000uF_25V 12.5x13mm | C18 | CAP_SMD_SIZE_H | CAP_POL_SMD | 1
10nF | 10nF | C28 | CAP-0603 | CAP-NON-POLAR | 1
1nF | 1nF | C29 | CAP-0603 | CAP-NON-POLAR | 1
1uF | 1uF | C30 | CAP-0603 | CAP-NON-POLAR | 1
0.1uF | 0.1uF | C31 | CAP-0805 | CAP-NON-POLAR | 1
ES1G | Ultrafast | D1 | FP-403AE-MFG | ES1G | 1
SS34-E3/9AT | DIODE SCHOTTKY 40V 3A DO214AB | D2 | FP-SMC-MFG | CMP-02539-000066-1 | 1
SS14 | SS14 | D3, D4, D5, D6 | DO-214-AC | SS14 | 4
LED_BLUE | 0805 | D7 | LED_BLUE | LED | 1
LED_GREEN | LED_GREEN | D8, D9 | LED_GREEN | LED | 2
LED_RED | LED_RED | D10, D11 | LED_RED | LED | 2
LED_YELLOW | LED_YELLOW | D12 | LED_YELLOW | LED | 1
KF2510 Connector 2.54mm | KF2510 Connector 2.54mm | J1 | Sullins_SWR25X-NRTC-S06-ST-BA_MFG | SWR25X-NRTC-S06-ST-BA | 1
B6B-XH-A | B6B-XH-A | J2 | B6B-XH-TW | B6B-XH-TW | 1
V23079-A2003-B301 | V23079-A2003-B301 12VDC 1A Tyco axicom | K1, K2 | V23079-A1001-B301 | F1CA005V | 2
470µH | MSRH5D28-471MT | L1 | WE-PD2_5848 | 744774033 | 1
220uH |  | L2 | Coil_4.5x4.5_mm | Coil | 1
27µH, 1.95A | WE-PD2 SMT Power Inductor, size 1054, 27µH, 1.95A, 0.11Ω | L3 | WE-PD2_1054 | 744776127 | 1
691305340003 | WR-TBL Series 3053 Horizontal PCB Header, THT, pitch 3.81mm, 3p | P1 | 691305340003 | 691305340003 | 1
691322310002 | WR-TBL Series 322 Horizontal PCB Header, THT, pitch 3.81mm, 2p | P2, P3 | 691322310002 | 691322310002 | 2
2.54mm 1X6 Pin Single Row | 2.54mm 1X6 Pin Single Row Male Connector PCB 25mm 1X6P Strip Pinheader | P4, P5 | PLS2.54 1x6 25mm | 2.54mm 1X6 Pin Single Row Male 25mm | 2
AO3400A | MOSFET N-CH 30V 5.7A SOT23 | Q1, Q2, Q3, Q4 | FP-SOT23-MFG | CMP-83955-000006-1 | 4
0.33 | 0.33 | R1 | RES-1206 | RES-CONST | 1
10K | 10K | R2, R3, R4, R5, R9, R11, R12, R15, R16, R25, R27, R32 | RES-0603 | RES-CONST | 12
100 | 100 | R6, R7, R13, R14, R28, R29, R30, R31 | RES-0603 | RES-CONST | 8
6.8K | 6.8K | R8 | RES-0805 | RES-CONST | 1
1.2K | 1.2K | R10 | RES-0805 | RES-CONST | 1
20K | 20K | R17 | RES-0603 | RES-CONST | 1
220 | 220 | R18, R19, R20, R21, R22, R26 | RES-0603 | RES-CONST | 6
1K | 1K | R23, R24 | RES-0603 | RES-CONST | 2
430152050826 | WS-TASV SMT Tact Switch, 6mm x 6mm, 260gf, SPST-NO, 12V, 50mA | SW1 | 430152050826 | 430152050826 | 1
Test_Point_PCB | Test_Point | TP1, TP2, TP3, TP4, TP5, TP9, TP12 | Test_Point | TP_PCB? | 7
Test_Point_PCB | Test_Point | TP8 | Pin_Test_Point(Orange) | TP_PCB? | 1
MC34063 |  | U1 | SOIC-8_M | MC34063 | 1
ADM2687E | ADM2687E | U2 | ADI-RI-16-2_M | ADM2687E | 1
AMS1117-3.3 | AMS1117-3.3 | U3, U6 | SOT-89 | AMS1117 | 2
STM32L452CCU6 | STM32L452CCU6 | U4 | UFQFPN48-7x7mm_STM | STM32L452CCU6 | 1
PC817XN | PC817XN | U5 | FP-PC817XNNIP0F-MFG | PC817XN | 1
AMS1117-5 | AMS1117-5 | U7 | SOT-89 | AMS1117 | 1
PSM712-LF-T7 | TVS Array - Asymmetrical Data Line Protector, 600 W, 7.5 V, -55 to 150 degC, 3-Pin SOT23, RoHS, Tape and Reel | U8 | PRKT-SOT23-3_V | CMP-2000-07553-1 | 1
XTAL 16Mhz | XTAL 16Mhz | Y1 | HC-49_SMD | XTAL 16Mhz | 1
