Chipizdry/Inverters-in-development/100kW_380V_Inverter/Driver/PS_Filter/Project Outputs for PS_Filter/PS_Filter.xlsx

Comment | Description | Designator | Footprint | LibRef | Quantity | Model number | Manufacturer | 5sets | Minimum quantity | Unit price | Total price
550V_470uF | 550V_470uF | C1, C2, C3, C4, C5, C6, C8, C9, C10, C11, C12, C14 | 500V_470uF | CAP_POL_LOW_IMP | 12 | EKP477M25Q60SWSHP | SANXIN | 60 | 60 | 2.9 | 174
4,7uF_630V | 4,7uF_630V | C7, C13 | CAP_4.7uF_630V | CAP-NON-POLAR | 2 | KP475J2J2603 | KYET | 10 | 10 | 0.36 | 3.6
0.1uF | 0.1uF | C15, C17, C19, C20, C24 | CAP-0603 | CAP-NON-POLAR | 5 | CC0603KRX7R9BB104 | YAGEO | 25 | 100 | 0.003 | 0.3
2.2uF | 2.2uF | C16, C18, C23 | CAP-0603 | CAP-NON-POLAR | 3 | 0603B225K250NT | FH | 15 | 20 | 0.036 | 0.72
10uF | 10uF | C21, C22 | CAP-0603 | CAP-NON-POLAR | 2 | CC0603MRX5R8BB106 | YAGEO | 10 | 20 | 0.043 | 0.86
2.2nF | 2.2nF | C25 | CAP-0603 | CAP-NON-POLAR | 1 | 0603B222K500NT | FH | 5 | 50 | 0.005 | 0.25
1nF | 1nF | C26 | CAP-0603 | CAP-NON-POLAR | 1 | CC0603KRX7R9BB102 | YAGEO | 5 | 50 | 0.003 | 0.15
KF136HT-10.16 | KF136HT-10.16 | J1, J2, J3, J4, J8, J9, J10, J11 | Conn_MEIGAN_MG136HT | Connector_MEIGAN_MG136HT | 8 | KF136HT-10.16 | KEFA | 40 | 40 | 0.29 | 11.6
18 * 18MM 180A PCB | 18 * 18MM 180A PCB High Current Solder Terminal Copper Terminal Fastener M8 Nut | J5, J6, J7, J14 | M8 Conn | Klema_15_A | 4 | 18 * 18MM 180A PCB | M8 | 20 | 20 | 0.86 | 17.2
61300611821 | WR-PHD Socket Header, THT, Vertical, pitch 2.54mm, 1 Row, 6P | J12, J13 | 61300611821 | 61300611821 | 2 | PM254V-11-06-H85 | XFCN | 10 | 10 | 0.086 | 0.86
SEV30ADXL | 5-1000V 30A DC Contactor Power Relay SEV30ADXL Coil 12V | K1, K2 | Relay_1000VDC_30A | Relay | 2 | SEV30ADXL |  | 10 | 10 | 17.8 | 178
Relay coil wire | Relay coil wire | K3, K4 | Relay_Coil | Coil_relay | 2 |  |  | 10 |  |  | 0
N87 40/24/16 | N87 40/24/16 2x10 Turns 1.5mm | L1 | Drossel_Synphaze | Drossel_Synphaze | 1 | t472715-2mh 50A |  | 5 | 5 | 7.4 | 37
301K | 301K 1% | R1, R2, R4, R5, R6, R8 | RES-2512 | RES-CONST | 6 | 301K/1%/2512 | YAGEO | 30 | 50 | 0.06 | 3
2.1K | 2.1K 0.1% | R3 | RES-2512 | RES-CONST | 1 | AC2512FK-072K1L | YAGEO | 5 | 10 | 0.06 | 0.6
3.5mOhm | 3.5mOhm 1% 3920 | R7 | RES-3921 | RES-CONST | 1 | HoXGS1050-5W-4mR-1% | Milliohm | 5 | 5 | 0.3 | 1.5
100 | 100W RX24 Aluminum Power Metal Shell Case Wirewound Resistor 100Omh | R9 | RES_100W_Aluminium | RES-CONST | 1 | HSC100100RJ |  | 5 | 5 | 1.5 | 7.5
33 Omh | 33 Omh | R10, R11, R12, R13 | RES-0603 | RES-CONST | 4 | 0603WAF330JT5E | UNI-ROYAL | 20 | 100 | 0.002 | 0.2
AMC1306M25 | AMC1306M25 | U2 | FP-DWV0008A-MFG | AMC1306M25 | 1 | AMC1306M25DWVR | TI | 5 | 5 | 1.6 | 8
AMC1336-Q1 | AMC1336-Q1 | U3 | FP-DWV0008A-MFG | AMC1336 | 1 | AMC1336QDWVRQ1 | TI | 5 | 5 | 4 | 20
B0505S-1W | B0505S-1W | U4, U5 | B0505S-1W | B0505S-1W | 2 | B0505S-1W | EVISUN | 10 | 10 | 0.5 | 5
PCB | FR-4 board, double-sided, 1.6mm thickness, green solder mask with white text, 1oz copper thickness, covered vias, lead-free spray tin |  |  |  | 5 |  |  | 5 |  |  | 44
SMT Stencil |  |  |  |  | 1 |  |  | 1 |  |  | 20
SMT Soldering Cost |  |  |  |  | 5 |  |  | 5 |  |  | 200
Freight cost |  |  |  |  | 5 |  |  | 5 |  |  | 120
47nF_2KV | 47nF_2KV | C27, C28 | 47nF_2kV | CAP-V | 10 |  |  |  |  |  | 854$
