Chipizdry/Inverters-in-development/100kW_380V_Inverter/Driver/Driver_BLDC/Driver_PCB/Project Outputs for Driver_BLDC/Driver_BLDC.xlsx

Comment | Description | Designator | Footprint | LibRef | Quantity
330pF | 330pF | C1, C2, C3, C87, C89, C90 | CAP-0805 | CAP-NON-POLAR | 6
100nF | 100nF | C4, C6, C64, C73, C97, C126 | CAP-0805 | CAP-NON-POLAR | 6
16V 100uF | 16V 100uF | C5 | CAP-TAN-D | CAP-POLAR | 1
47uF 16V | 47uF 16V | C7, C19, C21, C23, C30 | CAP-TAN-D | CAP-POLAR | 5
GRM21BR61C106KE15L | Chip Multilayer Ceramic Capacitors for General Purpose, 0805, 10uF, X5R, 15%, 10%, 16V | C8, C10 | FP-GRM21B-0_1-IPC_C | CMP-2007-03453-2 | 2
0.1uF | 0.1uF | C9, C12, C13, C14, C15, C16, C17, C25, C29, C31, C35, C36, C38, C40, C42, C45, C46, C52, C53, C54, C59, C60, C62, C66, C69, C72, C75, C77, C82, C94, C112, C123, C143 | CAP-0805 | CAP-NON-POLAR | 33
2.2nF 2kV | 2.2nF 2kV | C11, C78, C81, C83, C84, C85 | CAP-V | CAP-V | 6
2.2uF | 2.2uF | C18, C48 | CAP-0805 | CAP-NON-POLAR | 2
1uF | 1uF | C20, C22, C24, C34, C56, C57, C70, C86, C102, C115, C138 | CAP-0805 | CAP-NON-POLAR | 11
47pF | 47pF | C26, C27 | CAP-0805 | CAP-NON-POLAR | 2
1000pF | 1000pF | C28 | CAP-0805 | CAP-NON-POLAR | 1
100uF 16V | 100uF 16V | C32, C39, C61, C92, C110, C122, C142 | CAP-TAN-D | CAP_POL_SMD, CAP-POLAR | 7
1000uF 10V | 1000uF 10V | C33, C49, C63 | CAP_SMD_Size_G | CAP-POLAR | 3
1000uF_6.3V |  | C37, C43, C44, C50, C51, C67, C68 | CAP_SMD_Size_E | CAP-POLAR | 7
220pF | 220pF | C41 | CAP-0805 | CAP-NON-POLAR | 1
25V_1000uF | 25V_1000uF | C47, C55 | HITANO 3300uF 25V 16x25 | CAP-POLAR | 2
35V 220uF | 35V 220uF 8x10.5 | C58, C71, C88, C104, C117, C139 | CAP_SMD_Size_E | CAP-POLAR | 6
2.2nF | 2.2nF | C65, C98, C127 | CAP-0805 | CAP-NON-POLAR | 3
270pF | 270pF | C74 | CAP-0805 | CAP-NON-POLAR | 1
0.33uF | 0.33uF | C76 | CAP-0805 | CAP-NON-POLAR | 1
10nF 2kV | 10nF 2kV | C79, C80 | CAP-V | CAP-V | 2
151031YS06000 | WURTH ELEKTRONIK - 151031YS06000 - LED, Yellow, Through Hole, T-1 (3mm), 30 mA, 2 V, 590 nm | D1, D6, D7, D9 | LED_RED | LED | 4
151031YS06000 | WURTH ELEKTRONIK - 151031YS06000 - LED, Yellow, Through Hole, T-1 (3mm), 30 mA, 2 V, 590 nm | D2, D5 | LED_GREEN | LED | 2
151031YS06000 | WURTH ELEKTRONIK - 151031YS06000 - LED, Yellow, Through Hole, T-1 (3mm), 30 mA, 2 V, 590 nm | D3 | LED_YELLOW | LED | 1
151031YS06000 | WURTH ELEKTRONIK - 151031YS06000 - LED, Yellow, Through Hole, T-1 (3mm), 30 mA, 2 V, 590 nm | D4, D8 | LED_BLUE | LED | 2
SS36 | SS36 | D10 | SMC/DO214AB | SS36_Schottky | 1
1N4148 |  | D11, D13, D15 | DIOD-SOD123-2_V | 1N4148 | 3
US1G | US1G | D12, D14, D17, D19, D21, D24 | US1G_SMA | US1G | 6
ACS724 | ACS724 10A | DD1 | SO8-150 | ACS712 | 1
HEAT SINK | DNP | H1 | HEAT SINK | HEAT SINK | 1
MG_136_HT | MG_136_HT | J1, J2, J3, J4, J5, J7 | Conn_MEIGAN_MG136HT | Connector_MEIGAN_MG136HT | 6
DB9 pcb |  | J6 | DB9 conn pcb | DB9 | 1
B6B-XH-TW |  | J10, J13 | B6B-XH-TW | B6B-XH-TW | 2
G(4) | DNP | J14 | Klema_PCB_15A | Klema_15_A | 1
E(5) | DNP | J16 | Klema_PCB_15A | Klema_15_A | 1
G(6) | DNP | J19 | Klema_PCB_15A | Klema_15_A | 1
E(7) | DNP | J21 | Klema_PCB_15A | Klema_15_A | 1
G | DNP | J24, J29, J34, J38 | Klema_PCB_15A | Klema_15_A | 4
E | DNP | J26, J31, J36, J40 | Klema_PCB_15A | Klema_15_A | 4
 |  | J48, J49, J52, J53 | Sullins_SWR25X-NRTC-S06-ST-BA_MFG | SWR25X-NRTC-S06-ST-BA | 4
100uH CD105 | 100uH CD105 | L1, L2 | WE-PD2_1054 | 744776122 | 2
744776227 | 100uH CD105 | L3 | WE-PD2_1054 | CMP-0227-00501-2 | 1
220uH CD75 | 220uH CD75 | L4, L6, L7 | WE-PD2_7850 | 74477530 | 3
691305540002 | WR-TBL Series 3055 PCB Header Horizontal Entry with Plastic Latches, THT, pitch 5.08mm, 2p | P1, P8, P9, P10 | 691305540002 | 691305540002 | 4
61900311121 | WR-WTB THT Male Vertical Locking Header, pitch 2.54mm, 3p | P4, P5, P13, P14, P15 | 61900311121 | 61900311121 | 5
691305540003 | WR-TBL Series 3055 PCB Header Horizontal Entry with Plastic Latches, THT, pitch 5.08mm, 3p | P6, P7 | 691305540003 | 691305540003 | 2
BC847C | NPN Silicon AF Transistor, 45 V VCEO, 100 mA IC, SOT23, Reel, Green | Q1, Q2, Q3 | INF-SOT23_N | BC847C_Infineon | 3
BSS84 | P-mosfet | Q4 | FP-SOT23-IPC_A | BSS84 | 1
10K | 10K | R1, R2, R3, R4, R5, R6, R13, R14, R15, R16, R17, R18, R19, R20, R21, R24, R25, R26, R27, R28, R31, R33, R34, R35, R37, R38, R40, R41, R42, R43, R44, R45, R48, R49, R51, R53, R56, R57, R58, R59, R61, R69, R73, R81, R88, R95, R108, R113, R118, R120, R121, R122, R123, R124, R125, R128, R135, R143, R147, R152 | RES-0805 | RES-CONST | 60
220 | 220 | R7, R8, R9, R10, R11, R12, R39, R46, R47 | RES-0805 | RES-CONST | 9
20K | 20K | R22, R23 | RES-0805 | RES-CONST | 2
30K | 30K | R29, R30 | RES-0805 | RES-CONST | 2
100 | 100 | R32, R36 | RES-0805 | RES-CONST | 2
1K | 1K | R50, R54, R55, R63, R64, R78, R84, R86, R87, R91, R93, R98, R99, R102, R103, R109, R110, R111, R116, R117, R126, R127, R140 | RES-0805 | RES-CONST | 23
47K | 47K | R52 | RES-0805 | RES-CONST | 1
10 | 10 | R60, R77, R92, R115, R131, R149 | RES-2512 | RES-CONST | 6
1K | 1K | R62, R82, R96, R119, R136, R153 | RES-2512 | RES-CONST | 6
36K | 36K | R65 | RES-0805 | RES-CONST | 1
100K | 100K | R66, R72, R107, R146 | RES-0805 | RES-CONST | 4
11K | 11K | R67 | RES-0805 | RES-CONST | 1
2K | 2K | R68 | RES-0805 | RES-CONST | 1
100K | 100K 1%, 100K 1% | R70, R71, R74 | RES-2512 | RES-CONST | 3
1K 1% | 1K 1% (DNP) | R75 | RES-0805 | RES-CONST | 1
3K | 3K | R76, R104, R132 | RES-0805 | RES-CONST | 3
1M | 1M | R79 | RES-0805 | RES-CONST | 1
1K 1% | 1K 1% | R80 | RES_SMD_1210_IPC_B | RES_1210 | 1
5 | 5 | R83, R85, R89, R90, R94, R97, R100, R101, R105, R106, R112, R114 | RES-0805 | RES-CONST | 12
BC847C |  | T1 | SOT23-3_IPC_A | BC847C | 1
 | Test_Point | TP1, TP2, TP3, TP6, TP7, TP8, TP16, TP24, TP28, TP29, TP61 | Test_Point | TP_PCB? | 11
Test_Point_PCB | Test_Point | TP4, TP5, TP9, TP10, TP11, TP12, TP13, TP14, TP15, TP17, TP18, TP19, TP20, TP21, TP22, TP23, TP25, TP26, TP27, TP31, TP34, TP36, TP40, TP41, TP42, TP43, TP44, TP46, TP47, TP48, TP49, TP50, TP52, TP53, TP54, TP56, TP57, TP58, TP59, TP62, TP64, TP65, TP66, TP67, TP69 | Test_Point | TP_PCB? | 45
Test_Point_PCB | Test_Point | TP30 | Pin_Test_Point(Pink) | TP_PCB? | 1
DC-DC | Mounted by the customer | U1, U6, U10 | DC-DC_Bridge | DC-DC/12-18VDC | 3
B0505S-1W | B0505S-1W | U2, U12 | B0505S-1W | B0505S-1W | 2
MAX485 |  | U3 | SOIC-8-MFG | MAX485 | 1
ADUM1401BRWZ | Quad Channel Digital Isolator, 2.5 KV rms Insulation Rating, 10 Mbps Data Rate, 50 ns Delay, Industrial, 16-pin SOIC (RW-16), Tube | U4 | ADI-RW-16_M | CMP-0534-00565-1 | 1
AD8605ARZ | AD8605ARZ | U5 | SOT-23-5 | MCP6001T | 1
AMC1311 |  | U7 | FP-DWV0008A-MFG | AMC1311 | 1
STM32F722RET6 |  | U8 | LQFP64-5W-IPC_A | STM32F722RET6 | 1
AMS1117-3v3 | AMS1117-3v3 | U9, U11 | SOT-223-3 | AMS1117 | 2
UCC21520DW | UCC21520DW | U13, U21, U32 | FP-DW0016B-MFG | UCC21520DW | 3
AD8605ARZ | AD8605ARZ | U14 | SOT-23-5 | MCP6001T | 1
W25Q128 | W25Q128 | U15 | WINB-SOIC-8_M | W25Q128 | 1
SN74HC541DWR | SN74HC541DWR | U16 | DW0020A_L | SN74HC541DWR | 1
AMS1117-5V1 | AMS1117-5V1 | U17, U19 | SOT-223 | AMS1117 | 2
LM2576HVS-ADJ | LM2576HVS-ADJ | U18 | ON_Semiconductor_936A-02_MFG | LM2576D2T-005G | 1
PC817XN |  | U20 | FP-PC817XNNIP0F-MFG | PC817XN | 1
SMBJ18CA |  | VD2, VD6, VD11, VD15, VD21, VD25 | DO-214AA | Suppressor | 6
5.1V | 1N4733A 5.1V | VD4, VD8, VD13, VD17, VD23, VD27 | DO-35 | ZENER | 6
IGBT 75N120T | IGBT 75N120T TO-247-3 DNP, IGBT 75N120T TO-264-3 | VT1, VT2, VT3, VT4, VT5, VT6, VT7, VT8, VT9, VT10, VT11, VT12 | TO-264-3 | IGBT 60N120T | 12
FOXSLF/120-20 | Resistance Weld Thru-Hole Crystal, 12 MHz, +/-30 ppm, -20 to 70 degC, 2-Pin THD, RoHS, Bulk | Y1 | FOX-FOXSLF-2_V | CMP-1749-00004-1 | 1
P6SMB16CA |  | ZD1, ZD2 | DO-214AA | P6SMB16CA | 2
