Chipizdry/Inverters-in-development/100kW_380V_Inverter/Current_Sensors/Current_Sensors/Current_sensors.step

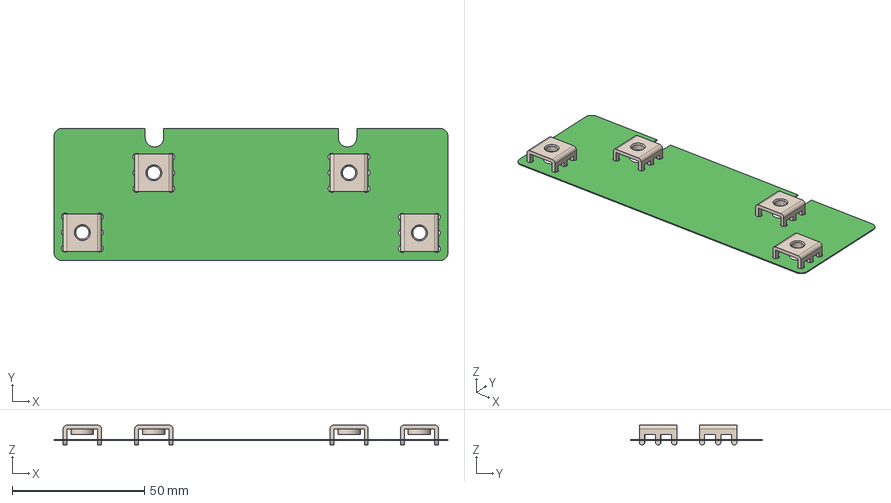
[picture p20: CAD file, 2026-07-15]
100kW_380V_Inverter/Current_Sensors/Current_Sensors/Current_sensors.step
149.0 x 50.0 x 7.50 mm
