Chipizdry/Inverters-in-development/(list of files, cad)

Other CAD files:
100kW_380V_Inverter/Driver/Инвертор.dwg
100kW_380V_Inverter/Driver/Маховик.dwg
