Chipizdry/Inverters-in-development/(list of files, drawings)

Other design files:
100kW_380V_Inverter/BUCK-BOOST_DC-DC/BUCK-BOOST_DC-DC.PcbDoc
100kW_380V_Inverter/BUCK-BOOST_DC-DC/BUCK-BOOST_DC-DC.PrjPcb
100kW_380V_Inverter/BUCK-BOOST_DC-DC/BUCK-BOOST_DC-DC.SchDoc
100kW_380V_Inverter/BUCK-BOOST_DC-DC/BUCK-BOOST_PWM_Controller/BUCK-BOOST_PWM_Controller.PrjPcb
100kW_380V_Inverter/BUCK-BOOST_DC-DC/BUCK-BOOST_PWM_Controller/BUCK-BOOST_PWM_Controller.SchDoc
100kW_380V_Inverter/BUCK-BOOST_DC-DC/DC-DC_PWM_IV_Controller/DC-DC_PWM_IV_Controller.PrjPcb
100kW_380V_Inverter/BUCK-BOOST_DC-DC/DC-DC_PWM_IV_Controller/DC-DC_PWM_IV_Controller.SchDoc
100kW_380V_Inverter/Current_Sensors/Current_Sensors/Current_sensors.PcbDoc
100kW_380V_Inverter/Current_Sensors/Current_Sensors/Current_Sensors.PrjPcb
100kW_380V_Inverter/Current_Sensors/Current_Sensors/Current_sensors.SchDoc
100kW_380V_Inverter/DC-DC-Conv/DC-DC_Conv.PrjPcb
100kW_380V_Inverter/DC-DC-Conv/DC-DC_Conv.SchDoc
100kW_380V_Inverter/DC-DC_30KW_BUCK-BOOST/DC-DC_30KW_BUCK-BOOST/DC-DC_30KW_BUCK-BOOST.PrjPcb
100kW_380V_Inverter/DC-DC_30KW_BUCK-BOOST/DC-DC_30KW_BUCK-BOOST/DC-DC_30KW_BUCK-BOOST.SchDoc
100kW_380V_Inverter/DC-DC_Bridge/DC-DC_Bridge.PrjPcb
100kW_380V_Inverter/DC-DC_Bridge/DC-DC_Bridge.SchDoc
100kW_380V_Inverter/DC-DC_BUCK-BOOST/DC-DC_BUCK-BOOST.PrjPcb
100kW_380V_Inverter/DC-DC_BUCK-BOOST/DC-DC_BUCK-BOOST.SchDoc
100kW_380V_Inverter/DC-DC_Conv_MCU/DC-DC_Conv_MCU/DC-DC_Conv_MCU_PCB/DC-DC_Conv_MCU.PcbDoc
100kW_380V_Inverter/DC-DC_Conv_MCU/DC-DC_Conv_MCU/DC-DC_Conv_MCU_PCB/DC-DC_Conv_MCU.PrjPcb
100kW_380V_Inverter/DC-DC_Conv_MCU/DC-DC_Conv_MCU/DC-DC_Conv_MCU_PCB/DC-DC_Conv_MCU.SchDoc
100kW_380V_Inverter/DC-DC_Isolation/DC-DC_Isolation.PcbDoc
100kW_380V_Inverter/DC-DC_Isolation/DC-DC_Isolation.PrjPcb
100kW_380V_Inverter/DC-DC_Isolation/DC-DC_Isolation.SchDoc
100kW_380V_Inverter/Driver/ADC_Comm/ADC_Comm/ADC_Comm.PcbDoc
100kW_380V_Inverter/Driver/ADC_Comm/ADC_Comm/ADC_Comm.PrjPcb
100kW_380V_Inverter/Driver/ADC_Comm/ADC_Comm/ADC_Comm.SchDoc
100kW_380V_Inverter/Driver/Driver_BLDC/Driver_PCB/Driver_BLDC.PrjPcb
100kW_380V_Inverter/Driver/Driver_BLDC/Driver_PCB/Driver_BLDC.SchDoc
100kW_380V_Inverter/Driver/Driver_BLDC/Driver_PCB/Optic_sensor/Optic_sensor.PcbDoc
100kW_380V_Inverter/Driver/Driver_BLDC/Driver_PCB/Optic_sensor/Optic_sensor.PrjPcb
100kW_380V_Inverter/Driver/Driver_BLDC/Driver_PCB/Optic_sensor/Optic_sensor.SchDoc
100kW_380V_Inverter/Driver/Driver_BLDC/Driver_PCB/Optic_sensor/QRE1113/QRE1113.PcbLib
100kW_380V_Inverter/Driver/Driver_BLDC/Driver_PCB/Optic_sensor/QRE1113/QRE1113.SchLib
100kW_380V_Inverter/Driver/Driver_BLDC/Driver_PCB/Optic_sensor_quad/Optic_sensor_quad.PcbDoc
100kW_380V_Inverter/Driver/Driver_BLDC/Driver_PCB/Optic_sensor_quad/Optic_sensor_quad.PrjPcb
100kW_380V_Inverter/Driver/Driver_BLDC/Driver_PCB/Optic_sensor_quad/Optic_sensor_quad.SchDoc
100kW_380V_Inverter/Driver/Driver_MainBoard/Driver.PrjPcb
100kW_380V_Inverter/Driver/Driver_MainBoard/Driver.SchDoc
100kW_380V_Inverter/Driver/Driver_MainBoard_Soft_Commutation/Driver_S_Comm.PrjPcb
100kW_380V_Inverter/Driver/Driver_MainBoard_Soft_Commutation/Driver_S_Comm.SchDoc
100kW_380V_Inverter/Driver/PS_Filter/PS_Filter.PrjPcb
100kW_380V_Inverter/Driver/PS_Filter/PS_Filter.SchDoc
100kW_380V_Inverter/FlyWheel_UI/FlyWheel_UI.PrjPcb
100kW_380V_Inverter/FlyWheel_UI/FlyWheel_UI.SchDoc
100kW_380V_Inverter/GATE_BOARD/GATE_BOARD.PcbDoc
100kW_380V_Inverter/GATE_BOARD/GATE_BOARD.PrjPCB
100kW_380V_Inverter/GATE_BOARD/GATE_BOARD.SchDoc
100kW_380V_Inverter/Inverter/Inverter.PrjPcb
100kW_380V_Inverter/Inverter/PCB1.PcbDoc
100kW_380V_Inverter/Inverter/Sheet1.SchDoc
100kW_380V_Inverter/Inverter_40-60_VDC_to_520-550_VDC/Driver_Test/Driver.PrjPcb
100kW_380V_Inverter/Inverter_40-60_VDC_to_520-550_VDC/Driver_Test/Driver.SchDoc
100kW_380V_Inverter/Inverter_40-60_VDC_to_520-550_VDC/Inverter_40-60_VDC_to_520-550_VDC_V2_TEST/Inverter_540VDC_V2_TEST.PrjPcb
100kW_380V_Inverter/Inverter_40-60_VDC_to_520-550_VDC/Inverter_40-60_VDC_to_520-550_VDC_V2_TEST/Inverter_540VDC_V2_TEST.SchDoc
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
