Chipizdry/Inverters-in-development/100kW_380V_Inverter/Driver/3PH_PWM/Core/Src/main.c

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
/* Includes ------------------------------------------------------------------*/
#include "main.h"
#include "cmsis_os.h"

/* USER CODE BEGIN Includes */
#include "stdbool.h"
#include "modbusDevice.h"
#include "modbusSlave.h"
#include "Registers_handler.h"
#include "DDS3PHASE.h"
#include "BLDC.h"
#include <math.h>
/* USER CODE END Includes */

/* USER CODE BEGIN PTD */

#define RX_BUFFER_SIZE 64
#define USART_TIMEOUT 900 // Таймаут в миллисекундах
#define ROTATE_TIME 2000
#define UPDATE_TIME 1000 //время прироста ШИМ на один шаг
#define ADC_NUM_CHANNELS 4  // Количество каналов
#define MODE_DRIVE 0
#define MODE_GEN 1

#define LUT_SIZE 2048


// Константы для избежания плавающей точки
#define CPU_FREQ_HZ 216000000
#define CALC_CONSTANT (60 * CPU_FREQ_HZ / NUM_MAGNETS)


#define ANGLE_OF_ATTACK 15
uint16_t adc_values[ADC_NUM_CHANNELS];
uint32_t lastActivityTime = 0;
 bool usartBusy = false;
 uint8_t rxFrame[128]={0,};
 uint8_t txFrame[128]={0,};
 uint8_t SLAVE_ID=2;
 uint16_t data_reg[32]={0,};
 uint16_t rcv_data_reg[32]={0,};
 uint16_t timer1Freq=0;
 uint16_t timer3Freq=0;
 uint16_t auto_mode_timer=0;
 uint32_t pwm=0;
 uint16_t pwm_boost=0;

 uint8_t dicreteInputs[200] = {0};
 uint8_t coils[200] = {0};


 uint32_t timerClockFreq = 216000000;
 volatile uint32_t period=0;
 uint16_t f=0;
 volatile uint32_t rpm=0;
 uint32_t moove=0;

 bool pwm_status=0;
 bool dataStates[16];
 bool coil_1=0;
 bool coil_2=0;
 bool coil_3=0;
 bool coil_4=0;

 bool BLDC_STATE[3] = {0,0,0};
 bool auto_mode=0;
 bool bldc_mode=0;
 bool pwr_on=0;

 /*Переменные для Hall+FOC */
volatile uint32_t hall_time_ticks = 0;
volatile uint32_t hall_period_ticks = 1000;
volatile float electrical_angle = 0.0f;
volatile uint8_t hall_sector = 0;
bool sinusoidal_active = false;


/* USER CODE END PTD */

ADC_HandleTypeDef hadc1;

SPI_HandleTypeDef hspi1;

TIM_HandleTypeDef htim1;
TIM_HandleTypeDef htim2;
TIM_HandleTypeDef htim3;
TIM_HandleTypeDef htim4;

UART_HandleTypeDef huart1;
DMA_HandleTypeDef hdma_usart1_rx;
DMA_HandleTypeDef hdma_usart1_tx;

/* Definitions for defaultTask */
osThreadId_t defaultTaskHandle;
const osThreadAttr_t defaultTask_attributes = {
  .name = "defaultTask",
  .stack_size = 256 * 4,
  .priority = (osPriority_t) osPriorityNormal,
};
/* Definitions for ModBusData */
osThreadId_t ModBusDataHandle;
const osThreadAttr_t ModBusData_attributes = {
  .name = "ModBusData",
  .stack_size = 256 * 4,
  .priority = (osPriority_t) osPriorityNormal,
};
void SystemClock_Config(void);
static void MPU_Config(void);
static void MX_GPIO_Init(void);
static void MX_DMA_Init(void);
static void MX_TIM1_Init(void);
static void MX_TIM2_Init(void);
static void MX_USART1_UART_Init(void);
static void MX_ADC1_Init(void);
static void MX_SPI1_Init(void);
static void MX_TIM3_Init(void);
static void MX_TIM4_Init(void);
void StartDefaultTask(void *argument);
void StartTask02(void *argument);

/* USER CODE BEGIN PFP */
void Check_USART1_Timeout(void);
void Reset_USART1(void);
void BLDC_MotorCommutation(uint8_t halls, uint16_t pwm);
uint16_t calculateTimerFrequency(TIM_TypeDef *TIMx, uint32_t timerClockFreq);
void BLDC_FlywheelCommutation(uint8_t halls ,uint16_t pwm , bool bldc_mode);
/* USER CODE END PFP */

/**
  * @brief  The application entry point.
  * @retval int
  */
int main(void)
{

  /* MPU Configuration--------------------------------------------------------*/
  MPU_Config();

  /* MCU Configuration--------------------------------------------------------*/

  /* Reset of all peripherals, Initializes the Flash interface and the Systick. */
  HAL_Init();

  /* Configure the system clock */
  SystemClock_Config();

  /* Initialize all configured peripherals */
  MX_GPIO_Init();
  MX_DMA_Init();
  MX_TIM1_Init();
  MX_TIM2_Init();
  MX_USART1_UART_Init();
  MX_ADC1_Init();
  MX_SPI1_Init();
  MX_TIM3_Init();
  MX_TIM4_Init();
  /* USER CODE BEGIN 2 */
  TX_2;
  LED_1_ON ;
  LED_2_ON ;
  LED_3_ON ;
  LED_4_ON ;
  LED_5_ON ;
  LED_6_ON ;
  LED_7_ON ;
  LED_8_ON ;
  HAL_Delay(500);
  DRIVE_1_ON;
  DRIVE_2_ON;
  DRIVE_3_ON;
  HAL_UARTEx_ReceiveToIdle_DMA(&huart1, rxFrame, RX_BUFFER_SIZE);
    __HAL_DMA_DISABLE_IT(&hdma_usart1_rx, DMA_IT_HT);
    HAL_TIM_Base_Start_IT(&htim1);
    HAL_TIM_Base_Start_IT(&htim2);
    HAL_TIM_IC_Start_IT(&htim2, TIM_CHANNEL_1);
    HAL_TIM_IC_Start_IT(&htim2, TIM_CHANNEL_2);
    HAL_TIM_IC_Start_IT(&htim2, TIM_CHANNEL_3);
    HAL_TIM_IC_Start_IT(&htim2, TIM_CHANNEL_4);

    LED_1_OFF ;
    LED_2_OFF ;
    LED_3_OFF ;
    LED_4_OFF ;
    LED_5_OFF ;
    LED_6_OFF ;
    LED_7_OFF ;
    LED_8_OFF ;
  //  DRIVE_1_OFF;
  //  DRIVE_2_OFF;
  //  DRIVE_3_OFF;
    RX_2;
    DDS_Init();

    HAL_TIM_PWM_Start(&htim1, TIM_CHANNEL_1);
    HAL_TIM_PWM_Start(&htim1, TIM_CHANNEL_2);
    HAL_TIM_PWM_Start(&htim1, TIM_CHANNEL_3);

    HAL_TIMEx_PWMN_Start(&htim1, TIM_CHANNEL_1);
    HAL_TIMEx_PWMN_Start(&htim1, TIM_CHANNEL_2);
    HAL_TIMEx_PWMN_Start(&htim1, TIM_CHANNEL_3);

  /* USER CODE END 2 */

  /* Init scheduler */
  osKernelInitialize();

  /* USER CODE BEGIN RTOS_MUTEX */
  /* add mutexes, ... */
  /* USER CODE END RTOS_MUTEX */

  /* USER CODE BEGIN RTOS_SEMAPHORES */
  /* add semaphores, ... */
  /* USER CODE END RTOS_SEMAPHORES */

  /* USER CODE BEGIN RTOS_TIMERS */
  /* start timers, add new ones, ... */
  /* USER CODE END RTOS_TIMERS */

  /* USER CODE BEGIN RTOS_QUEUES */
  /* add queues, ... */
  /* USER CODE END RTOS_QUEUES */

  /* Create the thread(s) */
  /* creation of defaultTask */
  defaultTaskHandle = osThreadNew(StartDefaultTask, NULL, &defaultTask_attributes);

  /* creation of ModBusData */
  ModBusDataHandle = osThreadNew(StartTask02, NULL, &ModBusData_attributes);

  /* USER CODE BEGIN RTOS_THREADS */
  /* add threads, ... */
  /* USER CODE END RTOS_THREADS */

  /* USER CODE BEGIN RTOS_EVENTS */
  /* add events, ... */
  /* USER CODE END RTOS_EVENTS */

  /* Start scheduler */
  osKernelStart();

  /* We should never get here as control is now taken by the scheduler */

  /* Infinite loop */
  /* USER CODE BEGIN WHILE */
  while (1)
  {

    /* USER CODE END WHILE */

    /* USER CODE BEGIN 3 */
  }
  /* USER CODE END 3 */
}

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
/* USER CODE BEGIN 4 */



uint16_t calculateTimerFrequency(TIM_TypeDef *TIMx, uint32_t timerClockFreq) {
    uint32_t arr = TIMx->ARR;        // Значение ARR
    uint32_t psc = TIMx->PSC;        // Значение Prescaler
    uint32_t actualFreq = timerClockFreq / (psc + 1);
    return actualFreq / (arr + 1);   // Частота в герцах
}


void Reset_USART1(void) {
    // Включить индикатор (если требуется)
    LED_4_ON;

    // Остановить передачу и прием по DMA
    if (HAL_UART_DMAStop(&huart1) != HAL_OK) {
        // Обработка ошибки
    }

    // Прерывание активных DMA транзакций
    if (hdma_usart1_rx.Instance != NULL) {
        HAL_DMA_Abort(&hdma_usart1_rx);
    }
    if (hdma_usart1_tx.Instance != NULL) {
        HAL_DMA_Abort(&hdma_usart1_tx);
    }

    // Отключить все прерывания UART
    __HAL_UART_DISABLE_IT(&huart1, UART_IT_IDLE | UART_IT_TC | UART_IT_RXNE);

    // Сбросить флаги ошибок UART
    __HAL_UART_CLEAR_OREFLAG(&huart1);
    __HAL_UART_CLEAR_FEFLAG(&huart1);

    // Сбросить периферийный модуль USART1
    __HAL_RCC_USART1_FORCE_RESET();
    HAL_Delay(1); // Задержка для завершения сброса
    __HAL_RCC_USART1_RELEASE_RESET();

    // Деинициализация UART
    if (HAL_UART_DeInit(&huart1) != HAL_OK) {
        // Обработка ошибки
    }

    // Повторная инициализация UART
    MX_USART1_UART_Init();

    // Повторная настройка DMA
    MX_DMA_Init();

    // Настройка UART для приема данных с использованием DMA
    if (HAL_UARTEx_ReceiveToIdle_DMA(&huart1, rxFrame, RX_BUFFER_SIZE) != HAL_OK) {
        // Обработка ошибки
    }
    __HAL_DMA_DISABLE_IT(&hdma_usart1_rx, DMA_IT_HT);

    // Сброс параметров и таймеров
    lastActivityTime = HAL_GetTick();
    LED_4_OFF;

}



void HAL_UART_TxCpltCallback(UART_HandleTypeDef *huart)

{
	    RX_2;
	    lastActivityTime = HAL_GetTick();
	    HAL_UARTEx_ReceiveToIdle_DMA(&huart1, rxFrame,RX_BUFFER_SIZE);
	    __HAL_UART_ENABLE_IT(&huart1, UART_IT_IDLE);
	    __HAL_DMA_DISABLE_IT(&hdma_usart1_rx, DMA_IT_HT);
       LED_4_OFF;
}


void HAL_UARTEx_RxEventCallback(UART_HandleTypeDef *huart, uint16_t Size)
{
	if (huart->Instance == USART1)
	{

		lastActivityTime = HAL_GetTick();
	    __HAL_UART_DISABLE_IT(&huart1, UART_IT_IDLE);
	    HAL_DMA_Abort(&hdma_usart1_rx);
	    Registers_handler(rxFrame, data_reg, rcv_data_reg,Size);

	}
}

void Hall_Event(void)
{
    uint32_t now = TIM2->CNT;

    hall_period_ticks = now - hall_time_ticks;
    hall_time_ticks = now;

    hall_sector = HallToSector(
        SWITCH(BLDC_STATE)
    );
}


float GetElectricalAngle(void)
{
    uint32_t dt;
    uint32_t now;

    __disable_irq();

    now = TIM2->CNT;

    dt = now - hall_time_ticks;

    uint32_t period = hall_period_ticks;
    uint8_t sector = hall_sector;

    __enable_irq();

    if(period == 0)
        return sector * 60.0f;

    if(dt > period)
        dt = period;

    float frac = (float)dt / (float)period;

    return sector * 60.0f + frac * 60.0f;
}




void Check_USART1_Timeout(void)
 {
     if (HAL_GetTick() - lastActivityTime >= USART_TIMEOUT)
     {
         Reset_USART1();
         RX_2;
     }
 }


void BLDC_FlywheelCommutation(uint8_t halls ,uint16_t pwm , bool bldc_mode)
{
    if (bldc_mode == MODE_DRIVE)
    {
    	LED_5_OFF;
        BLDC_MotorCommutation(halls,pwm);
    }
    if (bldc_mode == MODE_GEN)
    {
    	LED_5_ON;
        BLDC_GeneratorCommutation(halls, pwm);
    }
}

void HAL_GPIO_EXTI_Callback(uint16_t GPIO_Pin)
{
	static bool was_sinusoidal = false;
    uint16_t current_pwm = (bldc_mode == MODE_DRIVE) ? pwm : pwm_boost;

    if(GPIO_Pin == HALL_A_Pin)
    {
        if (GPIO_PIN_SET == HAL_GPIO_ReadPin(HALL_A_GPIO_Port, HALL_A_Pin))
        {
            LED_1_ON;
            BLDC_STATE[0] = 0;
          // if(rpm<2000){BLDC_FlywheelCommutation(SWITCH(BLDC_STATE), current_pwm, bldc_mode);}
        }
        else
        {
            LED_1_OFF;
            BLDC_STATE[0] = 1;
           // if(rpm<2000){BLDC_FlywheelCommutation(SWITCH(BLDC_STATE), current_pwm, bldc_mode);}
        }
    }

    if(GPIO_Pin == HALL_B_Pin)
    {
        if (GPIO_PIN_SET == HAL_GPIO_ReadPin(HALL_B_GPIO_Port, HALL_B_Pin))
        {
            LED_2_ON;
            BLDC_STATE[1] = 0;
          //  if(rpm<2000){BLDC_FlywheelCommutation(SWITCH(BLDC_STATE), current_pwm, bldc_mode);}
        }
        else
        {
            LED_2_OFF;
            BLDC_STATE[1] = 1;
           // if(rpm<2000){BLDC_FlywheelCommutation(SWITCH(BLDC_STATE), current_pwm, bldc_mode);}
        }
    }

    if(GPIO_Pin == HALL_C_Pin)
    {
        if (GPIO_PIN_SET == HAL_GPIO_ReadPin(HALL_C_GPIO_Port, HALL_C_Pin))
        {
            LED_3_ON;
            BLDC_STATE[2] = 0;
            //if(rpm<2000){BLDC_FlywheelCommutation(SWITCH(BLDC_STATE), current_pwm, bldc_mode);}
        }
        else
        {
            LED_3_OFF;
            BLDC_STATE[2] = 1;
           // if(rpm<2000){BLDC_FlywheelCommutation(SWITCH(BLDC_STATE), current_pwm, bldc_mode);}
        }
    }
    Hall_Event();




}



void HAL_TIM_IC_CaptureCallback(TIM_HandleTypeDef *htim)
{
    if (htim->Instance == TIM2)
    {
        if(htim->Channel == HAL_TIM_ACTIVE_CHANNEL_1)
        {

		  period = 0;
		      TIM2->CNT = 0;
		      period = HAL_TIM_ReadCapturedValue(&htim2, TIM_CHANNEL_2);

		      // Правильные константы для 216 MHz и 8 магнитов:
		      rpm = 1620000000 / period/2;  // 216M * 60 / 8 = 1620M
		      f = 27000000 / period/2;      // 216M / 8 = 27M

		      // Корректируем граничные значения:
		      if((period > 1620000000) || (period <= 2160)) {  // period <= 2160 = ~100,000 RPM
		          rpm = 0;
		          f = 0;
		      }

        }

        if(htim->Channel == HAL_TIM_ACTIVE_CHANNEL_2)
        {
        	 moove = HAL_GetTick();
        }

        if(htim->Channel == HAL_TIM_ACTIVE_CHANNEL_3)
        {

        }

        if(htim->Channel == HAL_TIM_ACTIVE_CHANNEL_4)
        {

        }
    }



}

/* USER CODE END 4 */

/* USER CODE BEGIN Header_StartDefaultTask */
/**
  * @brief  Function implementing the defaultTask thread.
  * @param  argument: Not used
  * @retval None
  */
/* USER CODE END Header_StartDefaultTask */
void StartDefaultTask(void *argument)
{
  /* USER CODE BEGIN 5 */
  /* Infinite loop */
  for(;;)
  {
	  Check_USART1_Timeout();
	      osDelay(1000);
  }
  /* USER CODE END 5 */
}

/* USER CODE BEGIN Header_StartTask02 */
/**
* @brief Function implementing the ModBusData thread.
* @param argument: Not used
* @retval None
*/
/* USER CODE END Header_StartTask02 */
void StartTask02(void *argument)
{
  /* USER CODE BEGIN StartTask02 */
  /* Infinite loop */

	 static uint8_t prev_bldc_mode = MODE_DRIVE;
  for(;;)
  {
	  // ===== 1. СНАЧАЛА читаем присланные данные =====
	  uint16_t new_arr = rcv_data_reg[3];
	  uint16_t new_pwm = rcv_data_reg[4];
	  uint16_t new_pwm_boost = rcv_data_reg[8];
	  uint16_t new_status = rcv_data_reg[7];
	  // ===== 2. Обновляем состояние из присланного статуса =====
	  uint8_t low_byte = (uint8_t)(new_status & 0xFF);
	  coil_1    = (low_byte >> 1) & 0x01;
	  coil_2    = (low_byte >> 2) & 0x01;
	  coil_3    = (low_byte >> 3) & 0x01;
	  coil_4    = (low_byte >> 4) & 0x01;
	  auto_mode = (low_byte >> 5) & 0x01;
	  pwr_on    = (low_byte >> 6) & 0x01;
	  bldc_mode = (low_byte >> 7) & 0x01;




      // ===== 4. Формируем ответные регистры (ИЗ ТЕКУЩЕГО СОСТОЯНИЯ!) =====
           uint32_t freqHz = calculateTimerFrequency(TIM1, timerClockFreq);

           data_reg[0] = freqHz;           // FREQ HI
           data_reg[1] = freqHz;           // FREQ LO
           data_reg[2] = rpm;              // RPM
           data_reg[3] = TIM1->ARR;        // TIMER_ARR
           data_reg[4] = pwm;              // PWM_CH1
           data_reg[5] = pwm;              // PWM_CH2
           data_reg[6] = pwm;              // PWM_CH3

           //формируем статус из текущих флагов
           uint16_t current_status = 0;
           current_status |= (coil_1 << 1);
           current_status |= (coil_2 << 2);
           current_status |= (coil_3 << 3);
           current_status |= (coil_4 << 4);
           current_status |= (auto_mode << 5);
           current_status |= (pwr_on << 6);
           current_status |= (bldc_mode << 7);

           data_reg[7] =current_status;   // STATUS
           data_reg[8] = pwm_boost;        // PWM_GEN


           osDelay(100);
  }
  /* USER CODE END StartTask02 */
}

 /* MPU Configuration */

void MPU_Config(void)
{
  MPU_Region_InitTypeDef MPU_InitStruct = {0};

  /* Disables the MPU */
  HAL_MPU_Disable();

  /** Initializes and configures the Region and the memory to be protected
  */
  MPU_InitStruct.Enable = MPU_REGION_ENABLE;
  MPU_InitStruct.Number = MPU_REGION_NUMBER0;
  MPU_InitStruct.BaseAddress = 0x0;
  MPU_InitStruct.Size = MPU_REGION_SIZE_4GB;
  MPU_InitStruct.SubRegionDisable = 0x87;
  MPU_InitStruct.TypeExtField = MPU_TEX_LEVEL0;
  MPU_InitStruct.AccessPermission = MPU_REGION_NO_ACCESS;
  MPU_InitStruct.DisableExec = MPU_INSTRUCTION_ACCESS_DISABLE;
  MPU_InitStruct.IsShareable = MPU_ACCESS_SHAREABLE;
  MPU_InitStruct.IsCacheable = MPU_ACCESS_NOT_CACHEABLE;
  MPU_InitStruct.IsBufferable = MPU_ACCESS_NOT_BUFFERABLE;

  HAL_MPU_ConfigRegion(&MPU_InitStruct);
  /* Enables the MPU */
  HAL_MPU_Enable(MPU_PRIVILEGED_DEFAULT);

}

/**
  * @brief  Period elapsed callback in non blocking mode
  * @note   This function is called  when TIM14 interrupt took place, inside
  * HAL_TIM_IRQHandler(). It makes a direct call to HAL_IncTick() to increment
  * a global variable "uwTick" used as application time base.
  * @param  htim : TIM handle
  * @retval None
  */
void HAL_TIM_PeriodElapsedCallback(TIM_HandleTypeDef *htim)
{
  if (htim->Instance == TIM14)
  {
    HAL_IncTick();
  }
  /* USER CODE BEGIN Callback 1 */
  if(htim->Instance == TIM1)
     {
         DDS_Update();
         HAL_GPIO_TogglePin(GPIOC, GPIO_PIN_11);
     }
}

  /* USER CODE END Callback 1 */


/**
  * @brief  This function is executed in case of error occurrence.
  * @retval None
  */
void Error_Handler(void)
{
  /* USER CODE BEGIN Error_Handler_Debug */
  /* User can add his own implementation to report the HAL error return state */
  __disable_irq();
  while (1)
  {
  }
  /* USER CODE END Error_Handler_Debug */
}
#ifdef USE_FULL_ASSERT
/**
  * @brief  Reports the name of the source file and the source line number
  *         where the assert_param error has occurred.
  * @param  file: pointer to the source file name
  * @param  line: assert_param error line source number
  * @retval None
  */
void assert_failed(uint8_t *file, uint32_t line)
{
  /* USER CODE BEGIN 6 */
  /* User can add his own implementation to report the file name and line number,
     ex: printf("Wrong parameters value: file %s on line %d\r\n", file, line) */
  /* USER CODE END 6 */
}
#endif /* USE_FULL_ASSERT */
