Chipizdry/Inverters-in-development/100kW_380V_Inverter/Driver/3PH_PWM/3PH_PWM.ioc

Mcu.UserName=STM32F722RETx
PA0-WKUP.Signal=ADCx_IN0
PA1.Signal=ADCx_IN1
PA10.Signal=S_TIM1_CH3
PA13.Signal=SYS_JTMS-SWDIO
PA14.Signal=SYS_JTCK-SWCLK
PA15.Signal=S_TIM2_CH1_ETR
PA2.Signal=ADCx_IN2
PA3.Signal=ADCx_IN3
PA4.Signal=ADCx_IN4
PA5.Signal=SPI1_SCK
PA6.Signal=S_TIM3_CH1
PA8.Signal=S_TIM1_CH1
PA9.Signal=S_TIM1_CH2
PB0.GPIO_Label=HALL_A
PB0.Signal=GPXTI0
PB1.GPIO_Label=HALL_B
PB1.Signal=GPXTI1
PB10.Signal=S_TIM2_CH3
PB11.GPIO_Label=CS_2
PB11.Signal=GPIO_Output
PB12.GPIO_Label=CS_3
PB12.Signal=GPIO_Output
PB13.Signal=TIM1_CH1N
PB14.Signal=TIM1_CH2N
PB15.Signal=TIM1_CH3N
PB2.GPIO_Label=HALL_C
PB2.Signal=GPXTI2
PB3.Signal=SYS_JTDO-SWO
PB4.Signal=SPI1_MISO
PB5.Signal=SPI1_MOSI
PB6.Signal=USART1_TX
PB7.Signal=USART1_RX
PB8.GPIO_Label=DIRECT
PB8.Signal=GPIO_Output
PB9.GPIO_Label=CS_1
PB9.Signal=GPIO_Output
PC0.GPIO_Label=Port_1
PC0.Signal=GPIO_Output
PC1.GPIO_Label=Port_2
PC1.Signal=GPIO_Output
PC10.GPIO_Label=LED_7
PC10.Signal=GPIO_Output
PC11.GPIO_Label=LED_8
PC11.Signal=GPIO_Output
PC2.GPIO_Label=Port_3
PC2.Signal=GPIO_Output
PC3.GPIO_Label=LED_1
PC3.Signal=GPIO_Output
PC4.GPIO_Label=LED_2
PC4.Signal=GPIO_Output
PC6.GPIO_Label=LED_3
PC6.Signal=GPIO_Output
PC7.GPIO_Label=LED_4
PC7.Signal=GPIO_Output
PC8.GPIO_Label=LED_5
PC8.Signal=GPIO_Output
PC9.GPIO_Label=LED_6
PC9.Signal=GPIO_Output
