Chipizdry/Inverters-in-development/100kW_380V_Inverter/Driver/Driver_MainBoard_Soft_Commutation/Driver_Flywheel_Soft_comm/Core/Inc/main.h

#define PORT_2_EN_Pin GPIO_PIN_13
#define PORT_2_EN_GPIO_Port GPIOC
#define PORT_3_EN_Pin GPIO_PIN_14
#define PORT_3_EN_GPIO_Port GPIOC
#define PORT_4_EN_Pin GPIO_PIN_15
#define PORT_4_EN_GPIO_Port GPIOC
#define DRV_6_Pin GPIO_PIN_1
#define DRV_6_GPIO_Port GPIOC
#define DRV_7_Pin GPIO_PIN_2
#define DRV_7_GPIO_Port GPIOC
#define DRV_1_Pin GPIO_PIN_3
#define DRV_1_GPIO_Port GPIOC
#define SENS_1_Pin GPIO_PIN_0
#define SENS_1_GPIO_Port GPIOA
#define SENS_2_Pin GPIO_PIN_1
#define SENS_2_GPIO_Port GPIOA
#define SENS_3_Pin GPIO_PIN_2
#define SENS_3_GPIO_Port GPIOA
#define SENS_4_Pin GPIO_PIN_3
#define SENS_4_GPIO_Port GPIOA
#define LED_6_Pin GPIO_PIN_4
#define LED_6_GPIO_Port GPIOA
#define HAL_A_Pin GPIO_PIN_5
#define HAL_A_GPIO_Port GPIOA
#define HAL_B_Pin GPIO_PIN_6
#define HAL_B_GPIO_Port GPIOA
#define HAL_C_Pin GPIO_PIN_7
#define HAL_C_GPIO_Port GPIOA
#define UI_INT_Pin GPIO_PIN_4
#define UI_INT_GPIO_Port GPIOC
#define DRV_8_Pin GPIO_PIN_5
#define DRV_8_GPIO_Port GPIOC
#define CS_1_Pin GPIO_PIN_0
#define CS_1_GPIO_Port GPIOB
#define CS_2_Pin GPIO_PIN_1
#define CS_2_GPIO_Port GPIOB
#define DRV_5_Pin GPIO_PIN_2
#define DRV_5_GPIO_Port GPIOB
#define INT_2_TIM_Pin GPIO_PIN_10
#define INT_2_TIM_GPIO_Port GPIOB
#define LED_1_Pin GPIO_PIN_11
#define LED_1_GPIO_Port GPIOB
#define LED_2_Pin GPIO_PIN_12
#define LED_2_GPIO_Port GPIOB
#define LED_3_Pin GPIO_PIN_13
#define LED_3_GPIO_Port GPIOB
#define LED_4_Pin GPIO_PIN_14
#define LED_4_GPIO_Port GPIOB
#define DRV_2_Pin GPIO_PIN_7
#define DRV_2_GPIO_Port GPIOC
#define DRV_3_Pin GPIO_PIN_8
#define DRV_3_GPIO_Port GPIOC
#define DRV_4_Pin GPIO_PIN_9
#define DRV_4_GPIO_Port GPIOC
#define INT_1_TIM_Pin GPIO_PIN_15
#define INT_1_TIM_GPIO_Port GPIOA
#define LED_5_Pin GPIO_PIN_11
#define LED_5_GPIO_Port GPIOC
#define PORT_1_EN_Pin GPIO_PIN_12
#define PORT_1_EN_GPIO_Port GPIOC
#define DIRECT_Pin GPIO_PIN_2
#define DIRECT_GPIO_Port GPIOD
