Chipizdry/Inverters-in-development/100kW_380V_Inverter/Driver/ADC_Comm/Firmware/ADC_Conn/Core/Inc/main.h

#define LED_1_Pin GPIO_PIN_0
#define LED_1_GPIO_Port GPIOA
#define LED_2_Pin GPIO_PIN_1
#define LED_2_GPIO_Port GPIOA
#define LED_3_Pin GPIO_PIN_2
#define LED_3_GPIO_Port GPIOA
#define RELAY_1_Pin GPIO_PIN_3
#define RELAY_1_GPIO_Port GPIOA
#define RELAY_2_Pin GPIO_PIN_4
#define RELAY_2_GPIO_Port GPIOA
#define LED_4_Pin GPIO_PIN_6
#define LED_4_GPIO_Port GPIOA
#define V_SENS_DATA_Pin GPIO_PIN_7
#define V_SENS_DATA_GPIO_Port GPIOA
#define LED_5_Pin GPIO_PIN_0
#define LED_5_GPIO_Port GPIOB
#define I_SENS_DATA_Pin GPIO_PIN_12
#define I_SENS_DATA_GPIO_Port GPIOB
#define DELAY_Pin GPIO_PIN_11
#define DELAY_GPIO_Port GPIOA
#define START_Pin GPIO_PIN_12
#define START_GPIO_Port GPIOA
#define BTN_Pin GPIO_PIN_3
#define BTN_GPIO_Port GPIOH
