Chipizdry/Inverters-in-development/100kW_380V_Inverter/Driver/3PH_PWM/Core/Inc/main.h

#define Port_1_Pin GPIO_PIN_0
#define Port_1_GPIO_Port GPIOC
#define Port_2_Pin GPIO_PIN_1
#define Port_2_GPIO_Port GPIOC
#define Port_3_Pin GPIO_PIN_2
#define Port_3_GPIO_Port GPIOC
#define LED_1_Pin GPIO_PIN_3
#define LED_1_GPIO_Port GPIOC
#define LED_2_Pin GPIO_PIN_4
#define LED_2_GPIO_Port GPIOC
#define HALL_A_Pin GPIO_PIN_0
#define HALL_A_GPIO_Port GPIOB
#define HALL_A_EXTI_IRQn EXTI0_IRQn
#define HALL_B_Pin GPIO_PIN_1
#define HALL_B_GPIO_Port GPIOB
#define HALL_B_EXTI_IRQn EXTI1_IRQn
#define HALL_C_Pin GPIO_PIN_2
#define HALL_C_GPIO_Port GPIOB
#define HALL_C_EXTI_IRQn EXTI2_IRQn
#define CS_2_Pin GPIO_PIN_11
#define CS_2_GPIO_Port GPIOB
#define CS_3_Pin GPIO_PIN_12
#define CS_3_GPIO_Port GPIOB
#define LED_3_Pin GPIO_PIN_6
#define LED_3_GPIO_Port GPIOC
#define LED_4_Pin GPIO_PIN_7
#define LED_4_GPIO_Port GPIOC
#define LED_5_Pin GPIO_PIN_8
#define LED_5_GPIO_Port GPIOC
#define LED_6_Pin GPIO_PIN_9
#define LED_6_GPIO_Port GPIOC
#define LED_7_Pin GPIO_PIN_10
#define LED_7_GPIO_Port GPIOC
#define LED_8_Pin GPIO_PIN_11
#define LED_8_GPIO_Port GPIOC
#define DIRECT_Pin GPIO_PIN_8
#define DIRECT_GPIO_Port GPIOB
#define CS_1_Pin GPIO_PIN_9
#define CS_1_GPIO_Port GPIOB
