Chipizdry/Inverters-in-development/100kW_380V_Inverter/Driver/ADC_Comm/Firmware/ADC_Conn/Core/Inc/Registers_handler.h

#ifndef INC_REGISTERS_HANDLER_H_
#define INC_REGISTERS_HANDLER_H_

#include "main.h"
#include "modbusDevice.h"
#include "modbusSlave.h"
#include "stm32l4xx_hal.h"
extern UART_HandleTypeDef huart1;
extern DMA_HandleTypeDef hdma_usart1_rx;
extern TIM_HandleTypeDef htim15;
extern uint8_t dicreteInputs[200];
extern uint8_t coils[200];
void Registers_handler( uint8_t* rxFrame,uint16_t* data_reg, uint16_t* rcv_data_reg,uint16_t Size);
void Modbus_parsing(uint8_t* rxFrame);
void RestartModbusReception(uint8_t* rxFrame);
#endif /* INC_REGISTERS_HANDLER_H_ */
