Chipizdry/Inverters-in-development/100kW_380V_Inverter/Driver/3PH_PWM/Core/Inc/BLDC.h

/*
 * BLDC.h
 *
 *  Created on: Jun 20, 2024
 *      Author: chipi
 */

#ifndef INC_BLDC_H_
#define INC_BLDC_H_


#include "main.h"
#include "stdbool.h"
extern TIM_HandleTypeDef htim1;
void Phaze_A_ON(uint16_t pwm);
void Phaze_A_OFF(uint16_t pwm);
void Phaze_A_ZZ(void);

void Phaze_B_ON(uint16_t pwm);
void Phaze_B_OFF(uint16_t pwm);
void Phaze_B_ZZ(void);

void Phaze_C_ON(uint16_t pwm);
void Phaze_C_OFF(uint16_t pwm);
void Phaze_C_ZZ(void);

uint8_t SWITCH( bool coils[]);
//void BLDC_MotorCommutation(uint8_t halls  );
void BLDC_MotorCommutation(uint8_t halls, uint16_t pwm);
void BLDC_GeneratorCommutation(uint8_t halls ,uint16_t pwm );
uint8_t HallToSector(uint8_t halls);

#endif /* INC_BLDC_H_ */
