Chipizdry/Inverters-in-development/(commit log)

2024-08-28 28/08/2024_Переделка под новый ШИМ контроллер
    [Inverter_540VDC.SchDoc, PWM_Controller_Half_Bridge_V2.PrjPCB, Standby_PS.SchDoc]
2024-09-05 05/09/2024 _Driver_update
    [BUCK-BOOST_PWM_Controller.SchDoc, Sheet1.SchDoc]
2024-10-01 01.10.2024_Инвертор 40-60VDC-540VDC
    [GATE_BOARD.PrjPCB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]
2024-10-15 15/10/2024_Трассировка платы драйвера(Контроллерная часть)
    [DRIVER POWER SUPPLY MODULE_Bottom_3D_Body.gbr, DRIVER POWER SUPPLY MODULE_Bottom_Assembly.gbr, DRIVER POWER SUPPLY MODULE_Bottom_Component_Center.gbr, DRIVER POWER SUPPLY MODULE_Bottom_Courtyard.gbr, DRIVER POWER SUPPLY MODULE_Copper_Signal_Bot.gbr, DRIVER POWER SUPPLY MODULE_Copper_Signal_Top.gbr, DRIVER POWER SUPPLY MODULE_Drawing_1.gbr, DRIVER POWER SUPPLY MODULE_Drillmap_1.gbr]
2024-10-23 23.10.2024_Дежурный БП правки после пусконаладки
    [PWM_Controller_Full_Bridge_TL494.PrjPCB, PWM_Controller_Full_Bridge_TL494.SchDoc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]
2024-11-04 04.11.2024_Бибилиотека с кварцами
    [FlyWheel_UI.SchDoc]
2024-11-17 17/11/2024_Правки
    [PWM_Controller_Full_Bridge_TL494.SchDoc, Push-Pull_Inverter.SchDoc]
2024-11-18 18.11.2024_Правки в схеме
    [PWM_Controller_Full_Bridge_TL494.SchDoc]
2024-11-18 18.11.2024_Правки
    [PWM_Controller_Full_Bridge_TL494.SchDoc]
2024-12-04 04.12.2024_ПО_драйвера_маховика
    [Push-Pull_Inverter.PrjPcb, Push-Pull_Inverter.SchDoc]
2024-12-21 21.12.2024_Отправка MODBUS
2024-12-25 25.12.2024_Стили экрана
    [T5LCFG.CFG]
2025-02-08 08.02.2025_Апдейт схемы
    [Driver_S_Comm.SchDoc, Push-Pull_Inverter.SchDoc]
2025-02-28 28/02/2025_Драйвер_мягкая _коммутация
    [Driver_S_Comm_Bottom_3D_Body.gbr, Driver_S_Comm_Bottom_Assembly.gbr, Driver_S_Comm_Bottom_Component_Center.gbr, Driver_S_Comm_Bottom_Courtyard.gbr, Driver_S_Comm_Copper_Signal_Bot.gbr, Driver_S_Comm_Copper_Signal_Top.gbr, Driver_S_Comm_Drawing_1.gbr, Driver_S_Comm_Drillmap_1.gbr]
2025-03-20 20.03.2025_Авто режим
    [Driver_Flywheel_Soft_comm (1).cfg, FlyWheel_UI.SchDoc]
2025-04-04 04/04/2025_Тестовый драйвер
    [Driver.PrjPcb, Driver.SchDoc, Push-Pull_Inverter.PrjPcb, Push-Pull_Inverter.SchDoc]
2025-04-11 11.04.2025-Трёхфазный счётчик
    [BOTTOM_BOARD.PcbDoc, BOTTOM_BOARD.PrjPCB, BOTTOM_BOARD.SchDoc, BOTTOM_BOARD_TRANS.PcbDoc, BOTTOM_BOARD_TRANS.PrjPCB, BOTTOM_BOARD_TRANS.SchDoc, DISPLAY_BOARD.PcbDoc, DISPLAY_BOARD.PrjPCB]
2025-05-12 12.05.2025_Измеритель мощности
    [U_I_Meter_Bottom.SchDoc, U_I_Meter_TOP.SchDoc]
2025-05-12 12/05/2025_ТГР_Solar_PS
    [U_I_Meter_TOP.SchDoc]
2025-05-14 14.05.2025_Задержка запуска
2025-05-16 16.05.2025_Контроллер ШИМ на SG3525
    [PWM_Controller_SG3525.PcbDoc, PWM_Controller_SG3525.PrjPCB, PWM_Controller_SG3525.SchDoc, U_I_Meter_TOP.SchDoc]
2025-08-12 12.08.2025_Высоковольтный БП
    [691305340002.PcbLib, 691305340003.PcbLib, CONN-2-PIN.SchLib, CONN-3-PIN.SchLib, PS__INN3947CQ.PrjPCB, PS__INN3947CQ.SchDoc, U_I_Meter_Bottom.PrjPcb, U_I_Meter_TOP.PrjPcb]
2025-08-15 15.08.2025_Дежурка инвертора
    [PWM_Controller_SG3525.PcbLib, PWM_Controller_SG3525.SchLib, Solar_950_VDC_Standby_PS.SchDoc]
2025-08-20 20.08.2025_Алгоритм двигателя
2025-08-21 21.08.2025_Компоненты инвертора
    [HEAT SINK.PcbLib, HEAT SINK.SchLib, Inverter_540VDC_V2.PrjPcb, Inverter_540VDC_V2.SchDoc, PS_DC-DC_15V_24V.PrjPcb, PS_DC-DC_15V_24V.SchDoc, PWM_CONTROLLER_nverter_540VDC_V2.PrjPcb, PWM_CONTROLLER_nverter_540VDC_V2.SchDoc]
2025-09-10 10/09/2025_Прошивки
    [691305340002.PcbLib, 691305340003.PcbLib, CONN-2-PIN.SchLib, CONN-3-PIN.SchLib, U_I_Meter Debug.cfg, U_I_Meter_Bottom.PcbDoc, U_I_Meter_Bottom.PrjPcb, U_I_Meter_Bottom.SchDoc]
2025-09-10 10/09/2025_Чистка проекта
    [Inverter_540VDC_V2_Bottom_3D_Body.gbr, Inverter_540VDC_V2_Bottom_Assembly.gbr, Inverter_540VDC_V2_Bottom_Component_Center.gbr, Inverter_540VDC_V2_Bottom_Courtyard.gbr, Inverter_540VDC_V2_Copper_Signal_Bot.gbr, Inverter_540VDC_V2_Copper_Signal_Top.gbr, Inverter_540VDC_V2_Drawing_1.gbr, Inverter_540VDC_V2_Drillmap_1.gbr]
2025-09-23 23.09.2025_Оптимизация проекта
    [691305340002.PcbLib, 691305340003.PcbLib, CONN-2-PIN.SchLib, CONN-3-PIN.SchLib, U_I_Meter Debug.cfg, U_I_Meter_Bottom.PcbDoc, U_I_Meter_Bottom.PrjPcb, U_I_Meter_Bottom.SchDoc]
2025-10-11 11.10.2025_библиотеки
    [PS_DC-DC_15V_24V.SchDoc, PS__INN3947CQ.PrjPCB]
2025-10-11 11/10/2025_Библиотеки
    [PS__INN3947CQ.PrjPCB, PS__INN3947CQ.SchDoc, PS__INN3947CQ_V2.PrjPCB, PS__INN3947CQ_V2.SchDoc]
2026-01-20 20.01.2026_Драйвер V 4.0
    [Driver_BLDC.PrjPcb, Driver_BLDC.SchDoc]
2026-01-22 22/01/2026_Драйвер маховика
    [Driver_BLDC.PrjPcb, Driver_BLDC.SchDoc]
2026-01-22 22.01.2026_Драйвер маховика
    [Driver_BLDC.SchDoc]
2026-02-04 04.02.2026_Апдейт
    [BOM.xlsx, Driver_BLDC.PrjPcb, Driver_BLDC.SchDoc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]
2026-02-27 27/02/2026_Драйвер маховика
    [Driver_BLDC.PrjPcb, Driver_BLDC.SchDoc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]
2026-02-27 27/02/2026_Драйвер в печать
    [Driver_BLDC.PrjPcb]
2026-04-27 27.04.2026 _Драйвер маховика
2026-04-30 30.04.2026 Оптический Датчик на 4
    [Driver_BLDC.PrjPcb, Driver_BLDC.SchDoc, Optic_sensor.PcbDoc, Optic_sensor.PrjPcb, Optic_sensor.SchDoc, Optic_sensor_quad.PcbDoc, Optic_sensor_quad.PrjPcb, Optic_sensor_quad.SchDoc]
2026-05-01 01/05/2026_BOM драйвера
    [Driver_BLDC.SchDoc, Optic_sensor_quad.PcbDoc, Optic_sensor_quad.xlsx]
2026-05-03 03.05.2026_Оптический датчик
    [Driver_BLDC.PrjPcb, Driver_BLDC.SchDoc, Optic_sensor_quad.PcbDoc, Optic_sensor_quad.PrjPcb, Optic_sensor_quad.SchDoc]
2026-05-21 21/05/2026_Блок фильтра
    [DC-DC_Isolation.PrjPcb, DC-DC_Isolation.SchDoc, DRIVER POWER SUPPLY MODULE.PrjPcb, DRIVER POWER SUPPLY MODULE.SchDoc, Driver_BLDC.PrjPcb, Driver_BLDC.xlsx, Driver_BOM.xlsx, Optic_sensor_quad.SchDoc]
2026-05-22 22/05/2026_Силовой блок
    [DRIVER POWER SUPPLY MODULE.SchDoc]
2026-05-25 25.05.2026_Блок конденсаторов
    [DRIVER POWER SUPPLY MODULE.SchDoc, PS_Filter.PrjPcb, PS_Filter.SchDoc]
2026-06-17 17.06.2026_АЦП_Коммутатор
    [ADC_Comm.PrjPcb, ADC_Comm.SchDoc, BUCK-BOOST_DC-DC.SchDoc, DC-DC_Bridge.PrjPcb, Driver_BLDC.PrjPcb, Driver_BLDC.SchDoc, GATE_BOARD.PcbDoc, GATE_BOARD.PrjPCB]
2026-06-25 25/06/2026_Управление драйверами
    [DC-DC_30KW_BUCK-BOOST.SchDoc]
2026-06-29 29/06/2026_DC-DC 30 KWT
    [DC-DC_30KW_BUCK-BOOST.PrjPcb, DC-DC_30KW_BUCK-BOOST.SchDoc]
2026-07-01 01.07.2026_DC-DC_по 2 транзистора
    [DC-DC_30KW_BUCK-BOOST.SchDoc, DC-DC_BUCK-BOOST.PrjPcb, DC-DC_BUCK-BOOST.SchDoc]
2026-07-06 06.07.2026_BUCK-BOOST в производство
    [DC-DC_BUCK-BOOST.PrjPcb, DC-DC_BUCK-BOOST.SchDoc]
2026-07-13 13/07/2026_ADC_Comm коррекция
    [ADC_Comm.SchDoc, ADC_Comm_.xlsx, DC-DC_Conv.SchDoc, DC-DC_Conv_MCU.PcbDoc, DC-DC_Conv_MCU.PrjPcb, DC-DC_Conv_MCU.SchDoc]
2026-07-21 Схема
    [DC-DC_Conv_MCU.PrjPcb, DC-DC_Conv_MCU.SchDoc]
2026-08-20 20/08/2026_Работы над схемой
2026-09-06 06.09.2026_Библиотеки
2026-10-11 11.10.2026_Обнова библиотеки
