Chipizdry/Inverters-in-development/(notices)

Notices in the files:
100kW_380V_Inverter/Driver/Driver_MainBoard_Soft_Commutation/Driver_Flywheel_Soft_comm/Core/Inc/main.h:
Copyright (c) 2024 STMicroelectronics.
All rights reserved.
This software is licensed under terms that can be found in the LICENSE file
100kW_380V_Inverter/Driver/3PH_PWM/Core/Inc/main.h:
Copyright (c) 2025 STMicroelectronics.
100kW_380V_Inverter/Driver/ADC_Comm/Firmware/ADC_Conn/Core/Inc/main.h:
Copyright (c) 2026 STMicroelectronics.
